rti-capture/rtiduino-pcb/gerbers/README.txt

rtiduino.GML	Mechanical (milling + outline)
rtiduino.GTL	TOP Copper
rtiduino.GTO	TOP silscreen
rtiduino.GTP	TOP paste
rtiduino.GTS	TOP solder mask
rtiduino.GBL	BOTTOM copper
rtiduino.GBO	BOTTOM silkscreen
rtiduino.GBP	BOTTOM paste
rtiduino.GBS	BOTTOM solder mask

rtiduino.TXT	EXCELLON drill file
	
rtiduino.dri	Drill information file
rtiduino.gpi	Photoplotter information file
