rti-capture/rtiduino-pcb/tester-1.0.xlsx

 | Number of Boards | 1
Qty | Value | Device | Package | Parts | Description | MPN | OC_FARNELL | Farnell £ | OC_Mouser | Mouser £ | Total QTY | Tot | Minimum | Multiple | Current Stock | Order Qty | Part, QTY | Item Cost | Total Cost | Order Farnel
1 |  | PINHD-1X2 | 1X02 | JP4 | PIN SOCKET | 2212S-02SG-85 | 1593458 | £0.0619 |  |  | 1 | 2 | 50 | 50 |  | 50 | 2212S-02SG-85 |50 | £0.0619 | £3.09 | 1593458,50
1 | ICSP | PINHD-2X3 | 2X03 | ICSP | PIN SOCKET | 2214S-06SG-85 | 1593488 | £0.1870 |  |  | 1 | 2 | 5 | 5 |  | 5 | 2214S-06SG-85 |5 | £0.1870 | £0.94 | 1593488,5
3 |  | PINHD-2X5 | 2X05 | JP7, JP8, JP9 | PIN SOCKET | 2214S-10SG-85 | 1593490 | £0.2620 |  |  | 3 | 4 | 5 | 5 |  | 5 | 2214S-10SG-85 |5 | £0.2620 | £1.31 | 1593490,5
1 |  | PINHD-2X8 | 2X08 | JP3 | PIN SOCKET | 2214S-16SG-85 | 1593492 | £0.3280 |  |  | 1 | 2 | 5 | 5 |  | 5 | 2214S-16SG-85|5 | £0.3280 | £1.64 | 1593492,5
1 | ICSP | PINHD-2X3 | 2X03 | ICSP1 | PIN HEADER | 826925-3 | 1248132 | £0.4810 |  |  | 1 | 2 | 10 | 10 | 13 | 0 | 826925-3 |0 | £0.4810 | £0.00
16 | 187 | R-EU_R0805 | R0805 | R35, R36, R37, R38, R39, R40, R41, R42, R43, R44, R45, R46, R47, R48, R49, R50 | RESISTOR, European symbol | MCWR08X1870FTL | 2695006 | £0.0048 |  |  | 16 | 18 | 10 | 10 |  | 20 | MCWR08X1870FTL |20 | £0.0048 | £0.10 | 2695006,20
26 | 200 | R-EU_R0805 | R0805 | R1, R2, R3, R4, R5, R6, R7, R8, R9, R10, R11, R12, R13, R14, R15, R16, R17, R18, R19, R20, R21, R22, R23, R24, R25, R26 | RESISTOR, European symbol | MCWR08X2000FTL | 2447602 | £0.0066 |  |  | 26 | 29 | 10 | 10 |  | 30 | MCWR08X2000FTL |30 | £0.0066 | £0.20 | 2447602,30
8 | 768 | R-EU_R0805 | R0805 | R27, R28, R29, R30, R31, R32, R33, R34 | RESISTOR, European symbol | ERJ6ENF7680V | 2303538 | £0.0386 |  |  | 8 | 9 | 10 | 10 |  | 10 | ERJ6ENF7680V |10 | £0.0386 | £0.39 | 2303538,10
6 | DOWN | 10-XX | B3F-10XX | GO, STOP, UP, DOWN, FOCUSON, RESET | OMRON SWITCH | SKHHAKA010 | 1656423 | £0.1540 |  |  | 6 | 7 | 10 | 10 | 10 | 0 | SKHHAKA010|0 | £0.1540 | £0.00
76 | Green | LEDCHIP-LED0805 | CHIP-LED0805 | QA0, QA1, QA2, QA3, QA4, QA5, QA6, QA7, QA8, QA9, QA10, QA11, QA12, QA13, QA14, QA15, QA16, QA17, QA18, QB0, QB1, QB2, QB3, QB4, QB5, QB6, QB7, QB8, QB9, QB10, QB11, QB12, QB13, QB14, QB15, QB16, QB17, QB18, QC0, QC1, QC2, QC3, QC4, QC5, QC6, QC7, QC8, QC9, QC10, QC11, QC12, QC13, QC14, QC15, QC16, QC17, QC18, QD0, QD1, QD2, QD3, QD4, QD5, QD6, QD7, QD8, QD9, QD10, QD11, QD12, QD13, QD14, QD15, QD16, QD17, QD18 | LED | KP-2012SGC | 1318243 | £0.0811 |  |  | 76 | 84 | 50 | 5 |  | 85 | KP-2012SGC|85 | £0.0811 | £6.89 | 1318243,85
8 | Orange | LEDCHIP-LED0805 | CHIP-LED0805 | B0, B1, B2, B3, B4, B5, B6, B7 | LED | KP-2012EC | 8529922 | £0.1030 |  |  | 8 | 9 | 5 | 5 |  | 10 | KP-2012EC|10 | £0.1030 | £1.03 | 8529922,10
18 | Red | LEDCHIP-LED0805 | CHIP-LED0805 | A0, A1, A2, A3, A4, A5, A6, A7, C0, C1, C2, C3, C4, C5, C6, C7, FOCUS, SHUTTER | LED | KP-2012SEC | 8529949 | £0.1500 |  |  | 18 | 20 | 5 | 5 |  | 20 | KP-2012SEC|20 | £0.1500 | £3.00 | 8529949,20
52 | Yellow | LEDCHIP-LED0805 | CHIP-LED0805 | QA19, QA20, QA21, QA22, QA23, QA24, QA25, QA26, QA27, QA28, QA29, QA30, QA31, QB19, QB20, QB21, QB22, QB23, QB24, QB25, QB26, QB27, QB28, QB29, QB30, QB31, QC19, QC20, QC21, QC22, QC23, QC24, QC25, QC26, QC27, QC28, QC29, QC30, QC31, QD19, QD20, QD21, QD22, QD23, QD24, QD25, QD26, QD27, QD28, QD29, QD30, QD31 | LED | KP-2012YC | 1318247 | £0.0804 |  |  | 52 | 58 | 50 | 5 |  | 60 | KP-2012YC|60 | £0.0804 | £4.82 | 1318247,60
1 | LCD-09395 | LCD-09395 | LCD-09395 | LCD1 | Screen |  | MK00650 | £18.9900 |  |  | 1 | 2 | 1 | 1 |  | 0 | |0 | £18.9900 | £0.00
8 | VO1400AEFTR | VO1400AEFTR | SOP4 | U1, U2, U3, U4, U5, U6, U7, U8 | MOSFET Relay | VO1400AEFTR | 2396109 | £0.7060 |  |  | 8 | 9 | 1 | 1 |  | 9 | VO1400AEFTR|9 | £0.7060 | £6.35 | 2396109,9
4 |  | Standoff | 8mm |  | 8mm Standoff for Screen | 970080151 | 2884509 | £0.3150 |  |  | 4 | 5 | 1 | 1 |  | 5 | 970080151|5 | £0.3150 | £1.57 | 2884509,5
8 |  | Screws | M2.5 x 5mm | Machine Screw | M2.5, 5 mm, Stainless Steel, Pan Head Torx | 01.64.212 | 2494522 | £0.0368 |  |  | 8 | 9 | 10 | 10 |  | 10 | 01.64.212|10 | £0.0368 | £0.37 | 2494522,10
8 |  | Washer | 2.65mm x 5.6mm |  | ylon, Flat, 2.65mm x 5.6mm Pack of 50 | 110764 | 7047472 | £1.3500 |  |  | 8 | 9 | 1 | 1 |  | 1 | 110764|1 | £1.3500 | £1.35 | 7047472,1 |  | 50-pack
 |  |  |  |  |  |  |  |  |  |  |  |  |  |  |  |  |  |  | £33.05 | £33.05
 |  |  |  |  |  |  |  |  |  |  |  |  |  |  |  |  |  |  |  |  | £0.00
 |  |  |  |  |  |  |  |  |  |  |  |  |  |  |  |  |  |  |  | £39.67 | £39.67
