rti-capture/rtiduino-pcb/rtiduino-1.3.xlsx

 | Number of Boards | 2
Qty | Value | Device | Package | Parts | Description | MPN | OC_FARNELL | Farnell £ | OC_Mouser | Mouser £ | Total QTY | Tot | Minimum | Multiple | Current Stock | Order Qty | Part, QTY | Item Cost | Total Cost | Order Farnel | Order Mouser
1 |  | 10-XX | B3F-10XX | S1 | OMRON SWITCH | SKHHAKA010 | 1656423 | £0.1540 | 688-SKHHAK | 0.2380 | 2 | 3 | 10 | 10 |  | 10 | SKHHAKA010|10 | £0.1540 | £1.54 | 1656423,10 |  |  | 1656423,10
1 |  | PINHD-1X6 | 1X06 | JP2 | PIN HEADER | 826629-6 | 3418327 | £0.5090 | 571-826629-6 | 0.4800 | 2 | 3 | 10 | 10 |  | 10 | 826629-6|10 | £0.5090 | £5.09 | 3418327,10
3 |  | PINHD-2X5 | 2X05 | JP7, JP8, JP9 | PIN HEADER | 826942-5 | 1248161 | £0.4900 |  |  | 6 | 7 | 10 | 10 | 12 | 0 | 826942-5|0 | £0.4900 | £0.00
1 |  | PINHD-2X8 | 2X08 | JP3 | PIN HEADER | 825440-8 | 3417803 | £1.8800 |  |  | 2 | 3 | 1 | 1 | 10 | 0 | 825440-8|0 | £1.8800 | £0.00
1 |  | PINHD-1x2 | 1X02 | JP4 | PIN HEADER | 826629-2 | 3418285 | £0.2780 |  |  | 2 | 3 | 10 | 10 | 20 | 0 | 826629-2|0 | £0.2780 | £0.00
1 |  | PN61729 | PN61729 | X4 | BERG USB connector | USBR-B-S-S-O-TH | 1753809 | £1.2400 |  |  | 2 | 1 | 1 | 1 |  | 2 | USBR-B-S-S-O-TH|2 | £1.2400 | £2.48 | 1753809,2
21 | 100nF | C-EUC0805K | C0805K | C1, C4, C9, C10, C13, C14, C15, C16, C18, C24, C25, C26, C27, C28, C30, C31, C42, C43, C44, C45, C46 | CAPACITOR, European symbol | 08051C104KAT2A | 1740681 | £0.1390 |  |  | 42 | 47 | 10 | 10 |  | 50 | 08051C104KAT2A|50 | £0.1390 | £6.95 | 1740681,50
1 | 100uF | CPOL-EUE5-13 | E5-13 | C7 | POLARIZED CAPACITOR, European symbol | UPM1J101MPD | 8812667 | £0.7960 |  |  | 2 | 3 | 1 | 1 |  | 3 | UPM1J101MPD|3 | £0.7960 | £2.39 | 8812667,3
8 | 10K | R-EU_R0805 | R0805 | R5, R10, R36, R42, R43, R44, R45, R46 | RESISTOR, European symbol | ASC0805-10KFT5 | 2078962 | £0.0213 |  |  | 16 | 18 | 10 | 10 | 50 | 0 | ASC0805-10KFT5|0 | £0.0213 | £0.00
1 | 10uF | EEE-FK1J100P-CASE-D | CAPAE660X610N | C12 | Aluminum Electrolytic Capacitors,Surface Mount Type | EEE-FK1J100P | 9696008 | £0.3090 |  |  | 2 | 3 | 1 | 1 | 1 | 2 | EEE-FK1J100P|2 | £0.3090 | £0.62 | 9696008,2
1 | 120uF | CPOL-EUE5-13 | E5-13 | C6 | POLARIZED CAPACITOR, European symbol | UPM1J121MPD | 8812675 | £0.1490 |  |  | 2 | 3 | 1 | 1 |  | 3 | UPM1J121MPD|3 | £0.1490 | £0.45 | 8812675,3
1 | 16MHz | CRYTALHC49S | HC49/S | Q2 | CRYSTAL | X16M000000L259 | 9509925 | £1.7800 |  |  | 2 | 3 | 1 | 1 | 1 | 2 | X16M000000L259|2 | £1.7800 | £3.56 | 9509925,2 |  |  | SC08178 | £0.7100
9 | 1K | R-EU_R0805 | R0805 | R1, R11, R12, R40, R41, R3, R6, R7, R9 | RESISTOR, European symbol | CRCW08051K00FKEA | 1469847 | £0.0655 | 71-CRCW0805-1.0K-E3 | 0.0650 | 18 | 20 | 10 | 10 | 24 | 0 | CRCW08051K00FKEA|0 | £0.0655 | £0.00
1 | 2.5MM-JACKPRO | 2.5MM-JACKPRO | 2.5-JACK-RA-PRO | J3 | 2.5mm Stereo Jack | MJ-2348BO | 1267387 | £4.4300 |  |  | 2 | 3 | 5 | 5 | 14 | 0 | MJ-2348BO|0 | £4.4300 | £0.00 |  | 5-pack
1 | 3.5MM-JACK | 3.5MM-JACK | 3.5-JACK-RA | J2 | 3.5mm Stereo Jack | KLBR 4 | 1217016 | £2.0100 |  |  | 2 | 3 | 1 | 1 |  | 3 | KLBR 4|3 | £2.0100 | £6.03 | 1217016,3
2 | 4.7uF | C-EUC0805K | C0805K | C29, C32 | CAPACITOR, European symbol | 0805YC475KAT2A | 1657937 | £0.3760 | 581-0805YC475KAT2A | 0.3880 | 4 | 5 | 1 | 1 |  | 5 | 0805YC475KAT2A|5 | £0.3760 | £1.88 | 1657937,5
1 | 4K7 | R-EU_R0805 | R0805 | R8 | RESISTOR, European symbol | MCWF08P4701FTL | 2694141 | £0.0144 |  |  | 2 | 3 | 10 | 10 |  | 10 | MCWF08P4701FTL|10 | £0.0144 | £0.14 | 2694141,10
2 | 500mA | L-EUL1812 | L1812 | F1, F2 | INDUCTOR, European symbol | 1206L025YR | 1596990 | £0.2740 | 576-1206L025YR | 0.2880 | 4 | 5 | 10 | 10 | 20 | 0 | 1206L025YR|0 | £0.2740 | £0.00
28 | 560 | R-EU_R0805 | R0805 | R2, R4, R13, R14, R15, R16, R17, R18, R19, R20, R21, R22, R23, R24, R25, R26, R27, R28, R29, R30, R31, R32, R33, R34, R35, R37, R38, R39 | RESISTOR, European symbol | MCHP05W4F5600T5E | 1576455 | £0.0421 |  |  | 56 | 62 | 10 | 10 |  | 70 | MCHP05W4F5600T5E|70 | £0.0421 | £2.95 | 1576455,70
1 | BAT54C | BAT54C | SOT23 | D4 | Schottky Diodes | BAT54C+ | 2675346 | £0.0823 |  |  | 2 | 3 | 5 | 5 | 8 | 0 | BAT54C+|0 | £0.0823 | £0.00
1 | DCJ0202 | JACK-PLUG0 | SPC4077 | J1 | DC POWER JACK | PPW01010 | 3498419 | £0.5400 |  |  | 2 | 3 | 1 | 1 | 2 | 1 | PPW01010|1 | £0.5400 | £0.54 | 3498419,1
1 | LED-DRIVER | LED-DRIVER | LDU08 | U6 | LED Driver | LDU0830S350 | 1738292 | £6.5700 |  |  | 1 | 2 | 1 | 1 |  | 2 | LDU0830S350|2 | £6.5700 | £13.14 | 1738292,2
1 | MBRS130 | DIODE-DO214AA | DO214AA | D5 | Schottky Rectifier | MBRS130 | 1467524 | £0.3450 | 512-MBRS130 | 0.3800 | 2 | 3 | 5 | 5 |  | 5 | MBRS130|5 | £0.3450 | £1.72 | 1467524,5
1 | SF37 | SF37 | DO-201AD | D2 | Ultrafast Diode | SF37 | 2677304 | £0.4740 |  |  | 2 | 3 | 5 | 5 |  | 5 | SF37|5 | £0.4740 | £2.37 | 2677304,5
1 | USB PROG | 47346-0001 | MOLEX_47346-0001 | J4 | CONN RCPT 5POS MICRO USB R/A SMD | 47346-0001 | 1568026 | £0.6250 | 538-47346-0001 | 0.7520 | 2 | 3 | 1 | 1 | 12 | 0 | 47346-0001|0 | £0.6250 | £0.00
4 |  | F15HPS | F15HP | X1, X5, X6, X7 | SUB-D | 3-106506-2 | 3417220 | £3.7600 |  |  | 8 | 9 | 1 | 1 | 3 | 6 | 3-106506-2|6 | £3.7600 | £22.56 | 3417220,6 |  |  | Male | F15HPS | 1-338169-2 | 2452348 | 454-3359
Misc Bits
1 | 1m | RibbonCable | 16-core |  | Ribbon Cable (screen/switches) | 3365-16 | 297318 | £2.3900 |  |  | 2 | 1 | 1 | 1 |  | 1 | 3365-16 |1 | £2.3900 | £2.39 | 297318,1
1 |  | IDC Connector | 2x08 |  | Ribbon Cable to Board | 90635-1161 | 3221956 | £0.7350 |  |  | 2 | 3 | 1 | 1 |  | 3 | 90635-1161|3 | £0.7350 | £2.21 | 3221956,3
1 | LCD-09395 | LCD-09395 | LCD-09395 | LCD1 | Screen | LCD-09395 | MK00650 | £18.9900 | 474-LCD-09395 | 22.1400 | 2 | 2 | 1 | 1 |  | 2 | LCD-09395|2 | £18.9900 | £37.98 | MK00650,2
5 |  | Switches | SPDT |  | Pushbutton Switch, Standard, 18000 Series, 6.5 mm, SPDT, On-(On), Plunger | 18535CD | 1082278 | £5.6800 |  |  | 5 | 5 | 1 | 1 |  | 5 | 18535CD|5 | £5.6800 | £28.40 | 1082278,5
1 |  | Green switch cap |  |  | Switch Cap, 18000 Series Snap Action Momentary Pushbutton Switches, Green | U483 | 1082523 | £0.5590 |  |  | 2 | 3 | 10 | 10 |  | 10 | U483|10 | £0.5590 | £5.59 | 1082523,10
1 |  | Red switch cap |  |  | Switch Cap, 13000 Series Snap Action Momentary Pushbutton Switches, Red | U486 | 1082524 | £0.5670 |  |  | 2 | 3 | 10 | 10 |  | 10 | U486|10 | £0.5670 | £5.67 | 1082524,10
3 |  | Black switch cap |  |  | Switch Cap, Snap Action Momentary Pushbutton Switches, Black | U482 | 1082522 | £0.3470 |  |  | 6 | 7 | 10 | 10 |  | 10 | U482|10 | £0.3470 | £3.47 | 1082522,10
4 |  | Female D-Sub |  |  |  | 5502-15SA-01-F1 | 1084693 | £0.4440 |  |  | 8 | 9 | 5 | 5 |  | 10 | 5502-15SA-01-F1 |10 | £0.4440 | £4.44 | 1084693,10
8 |  | Male D-Sub |  |  |  | 5502-15PA-01-F1 | CN11131 | £0.3300 |  |  | 8 | 8 | 1 | 1 |  | 8 | 5502-15PA-01-F1|8 | £0.3300 | £2.64 | CN11131,8 |  |  | 1084686
12 |  | D-Sub Shells |  |  |  | MHDM-15-K | 4303441 | £3.5900 |  |  | 12 | 12 | 1 | 1 | 3 | 9 | MHDM-15-K|9 | £3.5900 | £32.31 | 4303441,9
8 |  | D Sub Jack Screw |  |  |  | SPC15082. | CN21810 | £0.6400 |  |  | 16 | 16 | 1 | 1 |  | 16 | SPC15082.|16 | £0.6400 | £10.24 | CN21810,16 |  |  | 2293865
1 |  | Box |  |  | Plastic Enclosure, Desktop Case, Instrument, ABS, 70.75 mm, 140 mm, 190 mm, IP43 | MCRM2055L | 1635117 | £12.9300 |  |  | 2 | 3 | 1 | 1 |  | 2 | MCRM2055L|2 | £12.9300 | £25.86 | 1635117,2
 |  |  |  |  |  |  |  |  |  |  |  |  |  |  |  |  |  | £135.3350
1 | 330uH (DO3308P-334) | DO3316P | DO3316P | L3 | COILCRAFT | DO3308P-334MLB | 2457508 | £1.1100 | 994-DO3308P-334MLD | 1.6700 | 2 | 3 | 1 | 1 | 1 | 2 | DO3308P-334MLB|2 | £1.6700 | £3.34 |  | 994-DO3308P-334MLD |2
1 | DR73-680-R | DR73-680-R | INDM7676X355N | L2 | POWER INDUCTOR | DR73-680-R | 1653721 | £2.0800 | 704-DR73-680-R | 0.9200 | 2 | 3 | 1 | 1 | 1 | 2 | DR73-680-R|2 | £0.9150 | £1.83 |  | 704-DR73-680-R |2
1 | 3uH | WE-TPC-744053003_5818/5828 | WE-TPC_5818/5828 | L1 | Shielded Tiny Power Inductor WE-TPC | 744053003 | 2082565 | £1.5000 | 710-744053003 | 1.1600 | 2 | 3 | 1 | 1 | 1 | 2 | 744053003|2 | £1.1600 | £2.32 |  | 710-744053003|2
5 |  | LEDCHIP-LED0805 | CHIP-LED0805 | L, RX, RX1, TX, TX1 | LED | 150080RS75000 | 2322077 | £0.1770 | 150080RS75000 | 0.1370 | 10 | 11 | 5 | 5 | 20 | 0 | 150080RS75000|0 | £0.1370 | £0.00
3 | 22p | C-EUC0805K | C0805K | C2, C3, C11 | CAPACITOR, European symbol | 08051A220JAT2A | 317500 | £0.1210 | 581-08051A220J | 0.0920 | 6 | 7 | 10 | 10 |  | 10 | 08051A220JAT2A|10 | £0.0920 | £0.92 |  | 581-08051A220J|10
1 | 47UF | EEE-FK1J470P-CASE-F | CAPAE830X1050N | C8 | Aluminum Electrolytic Capacitors,Surface Mount Type | EEE-FK1J470P | 9696032 | £0.7610 | 667-EEE-FK1J470P | 0.5860 | 2 | 3 | 1 | 1 | 1 | 2 | EEE-FK1J470P|2 | £0.5860 | £1.17 |  | 667-EEE-FK1J470P|2
2 | FOD852 | FOD852 | DIP4-SMD | U5, U7 | Optocoupler | FOD8523S | 1495374 | £0.9070 | 512-FOD8523S | 0.7920 | 4 | 5 | 5 | 5 | 8 | 0 | FOD8523S|0 | £0.7920 | £0.00
24 | AQV252G | AQV252G | SOP6 | U10, U11, U12, U13, U14, U15, U16, U17, U20, U21, U22, U23, U24, U25, U26, U27, U30, U31, U32, U33, U34, U35, U36, U37 | MOSFET Relay | AQV252GA | 2396106 | £4.1800 | 769-AQV252GA | 3.7400 | 48 | 53 | 25 | 1 |  | 50 | AQV252GA|50 | £3.7400 | £187.00 |  | 769-AQV252GA|50
1 | ICSP | PINHD-2X3 | 2X03 | ICSP | PIN HEADER | 826925-3 | 1248132 | £0.4810 | 571-826925-3 | 0.4720 | 2 | 3 | 10 | 10 | 13 | 0 | 826925-3|0 | £0.4720 | £0.00
1 | LM2594HVM-5.0 | LM2594HVM-5.0 | SOIC127P620X175-8N | U3 | SIMPLE SWITCHER | LM2594HVM-5.0/NOPB | 3122872 | £5.3400 | 926-LM2594HVM5.0NOPB | 4.6600 | 2 | 3 | 1 | 1 | 3 | 0 | LM2594HVM-5.0/NOPB|0 | £4.6600 | £0.00
1 | 122-000-04-52 | 122-000-04-52 | 122-000-04-52 | U$28 | Circuit Board Indicator | 553-0112-200F | 1519390 | £2.0000 | 645-553-0112-200F | 1.5800 | 2 | 3 | 1 | 1 |  | 3 | 553-0112-200F|3 | £1.5800 | £4.74 |  | 645-553-0112-200F|3
1 | ATMEGA2560AU | ATMEGA2560AU | TQFP100 | U1 | MICROCONTROLLER | ATMEGA1280-16AU | 1455090 | £8.7600 | 556-ATMEGA1280-16AU | 8.4200 | 2 | 3 | 1 | 1 | 3 | 2 | ATMEGA1280-16AU|2 | £8.4200 | £16.84 |  | 556-ATMEGA1280-16AU|2
2 | FT232RL | FT232RL | SSOP28 | U2, U4 | USB UART | FT232RL | 1146032 |  | FT232RL-TUBE | 3.5600 | 4 | 5 | 1 | 1 | 1 | 4 | FT232RL|4 | £3.5600 | £14.24 |  | FT232RL-TUBE|4
1 | 68uF | CPOL-EUE5-13 | E5-13 | C5 | POLARIZED CAPACITOR, European symbol | UPW2A680MPD |  |  | 647-UPW2A680MPD | 0.4910 | 2 | 3 | 5 | 5 |  | 5 | UPW2A680MPD|5 | £0.4910 | £2.46 |  | 647-UPW2A680MPD|5
 |  |  |  |  |  |  |  |  |  |  |  |  |  |  |  |  |  |  | £470.46 | £209.74 | £234.8570
 |  |  |  |  |  |  |  |  |  |  |  |  |  |  |  |  |  |  | £564.55 | £209.74 | £234.86 | £444.60
 |  |  |  |  |  |  |  |  |  |  |  |  |  |  |  |  |  |  |  | £251.69 | £281.83 | £533.52
