rti-capture/rtiduino-pcb/rtiduino.xlsx

Qty | Value | Device | Package | Parts |  | onecall code | Avail? | minimum order | price | Quantity needed | Order Quantity | Line cost | Make | 2
10 | 100n | C-EU | C0805RND | C1, C4, C9, C10, C12, C13, C14, C15, C16, C17 | CAPACITOR, European symbol | 1740681 (http://onecall.farnell.com/avx/08051c104kat2a/cap-mlcc-0-1uf-100v-x7r-10-0805/dp/1740681) | Y | 10 | £0.20 | 20 | 20 | £4.00 | Total | £230.30
3 | 22p | C-EU | C0805RND | C2, C3, C11 | CAPACITOR, European symbol | 317500 (http://onecall.farnell.com/avx/08051a220jat2a/cap-mlcc-22pf-100v-c0g-np0-5-0805/dp/317500) | Y | 10 | £0.07 | 6 | 10 | £0.67
1 | 68uF | CPOL-EUE3.5-10 | E3,5-10 | C5 | POLARIZED CAPACITOR, European symbol | 9696210 (http://onecall.farnell.com/panasonic/eeued2c680/capacitor-68uf-160v/dp/9696210) | Y | 1 | £0.89 | 2 | 2 | £1.78
1 | 120uF | CPOL-EUR/2012-12R | R/2012-12R | C6 | POLARIZED CAPACITOR, European symbol | 1658060 | Y | 1 | £1.97 | 2 | 2 | £3.94
1 | 68uF | CPOL-EUR/2012-12R | R/2012-12R | C7 | POLARIZED CAPACITOR, European symbol | 1457489 | Y | 1 | £0.65 | 2 | 2 | £1.30
1 | 1N5817-B | 1N5817-B | DO41-7.6 | D1 | 1.0A SCHOTTKY BARRIER RECTIFIER | ALREADY BOUGHT |  |  |  | 2 | 2 | £0.00
1 | SF37 | SF37 | DO-201AD | D2 |  | 1625219 | Y | 1 | £0.11 | 2 | 2 | £0.23
1 | 500mA | L-EUL1812 | L1812 | F1 | INDUCTOR, European symbol | 1596990 (http://onecall.farnell.com/littelfuse/1206l025yr/fuse-resettable-1206-16v-250ma/dp/1596990) | Y | 10 | £0.36 | 2 | 10 | £3.60
1 | LM358D | LM358D | SO08 | IC7 | OP AMP also LM158; LM258; LM2904 | 1366578 (http://onecall.farnell.com/stmicroelectronics/lm358d/op-amp-dual-1-1mhz-0-6v-us-8soic/dp/1366578) | N | 1 | £0.45 | 2 | 2 | £0.90
1 | ICSP | PINHD-2X3 | 2X03 | ICSP | PIN HEADER | CN14399 (http://onecall.farnell.com/te-connectivity-amp/826925-3/header-straight-2x3way/dp/CN14399) | Y | 10 | £0.25 | 2 | 10 | £2.50
1 | DCJ0202 | JACK-PLUG0 | SPC4077 | J1 | DC POWER JACK unknown unknown | AV15150 | Y | 1 | £0.48 | 2 | 2 | £0.96
1 | 3.5MM-JACK | 3.5MM-JACK | 3.5-JACK-RA | J2 |  | 1217016 | Y | 1 | £1.25 | 2 | 2 | £2.50
1 | 2.5MM-JACK | 2.5MM-JACK | 2.5-JACK-RA | J3 |  | 1200127 | N | 1 | £0.91 | 2 | 2 | £1.82
3 |  | PINHD-2X5 | 2X05 | JP7, JP8, JP9 | PIN HEADER | 1248161 | Y | 10 | £0.60 | 6 | 10 | £6.00
3 |  | LED0805ROUND | 0805RND | L, RX, TX | LED | 2322077 (http://onecall.farnell.com/wurth-elektronik/150080rs75000/led-0805-red-150mcd-625nm/dp/2322077) | Y | 1 | £0.16 | 6 | 6 | £0.96
1 | 100uH | SBC10 | SBC10 | L1 | INDUCTOR | 2333635 | Y | 1 | £0.12 | 2 | 2 | £0.24
1 | 16MHz | CRYTALHC49S | HC49/S | Q2 | CRYSTAL | SC08178 (http://onecall.farnell.com/ael-crystals/x16m000000l259/crystal-16mhz/dp/SC08178) | Y (4) | 1 | £1.44 | 2 | 2 | £2.88
3 | 1K | R-EU_R0805 | R0805 | R1, R11, R12,R7, R9 | RESISTOR, European symbol | 1576459 (http://onecall.farnell.com/multicomp/mchp05w4f1001t5e/resistor-thick-film-1k-0-25w-1/dp/1576459) | Y | 50 | £0.06 | 6 | 50 | £3.00
24 | 560 | R-EU_R0805 | R0805 | R4, R13, R14, R15, R16, R17, R18, R19, R20, R21, R22, R23, R24, R25, R26, R27, R28, R29, R30, R31, R32, R33, R34, R35,R37, R38, R39 | RESISTOR, European symbol | 9334688 (http://onecall.farnell.com/multicomp/mc01w08055560r/resistor-0805-560r/dp/9334688) | Y | 50 | £0.03 | 48 | 50 | £1.50
2 | 10K | R-EU_R0805 | R0805 | R5, R36,R6, R10 | RESISTOR, European symbol | 2078962 | Y | 100 |  | 4 | 100 | £0.00
1 |  | SJ | SJ | RESET-EN | SMD solder JUMPER | - |  | - | - | 2 | -
1 |  | 10-XX | B3F-10XX | S1 | OMRON SWITCH | 1656423 | Y | 5 | £0.12 | 2 | 5 | £0.60
1 | NDT2955 | PMOSSOT223 | SOT223 | T1 | MOS FET | SC11042 (http://onecall.farnell.com/fairchild-semiconductor/ndt2955/mosfet-p-ch-60v-2-5a-sot-223/dp/SC11042) | Y (8) | 1 | £0.50 | 2 | 2 | £1.00
1 | FDN340P | PMOSSOT23 | SOT-23 | T2 | MOS FET | optional |  | - | - | 2 | -
1 | 122-000-04-52 | 122-000-04-52 | 122-000-04-52 | U$28 |  | 9737340 | Y | 1 | £2.59 | 2 | 2 | £5.18
1 | ATMEGA2560AU | ATMEGA2560AU | TQFP100 | U1 | MICROCONTROLLER | 1455090 | Y | 1 | £9.99 | 2 | 2 | £19.98
25 | AQV252G | AQV252G | SOP6 | U10, U11, U12, U13, U14, U15, U16, U17, U20, U21, U22, U23, U24, U25, U26, U27, U30, U31, U32, U33, U34, U35, U36, U37 |  | 2396106 | Y (130) | 1 | £3.86 | 25 | 25 | £96.50
1 | LDU240S500 | LDU240S500 | RELAY_LDU2430S700 | U2 |  | 1738293 |  | 1 | £8.92 | 2 | 2 | £17.84
1 | LM2594HVM-5.0 | LM2594HVM-5.0 | SOIC127P620X175-8N | U3 | SIMPLE SWITCHER LM2594HVM-33 1564635 41K3809 SOIC-8 National Semiconductor | 1469190 | Y | 1 | £3.53 | 2 | 2 | £7.06
1 | FT232RL | FT232RL | SSOP28 | U4 |  | 1146032 | Y | 1 | £3.92 | 2 | 2 | £7.84
1 | FOD852 | FOD852 | DIP4-SMD | U5 |  | 1495374 | Y | 5 | £0.70 | 2 | 5 | £3.50
4 |  | F15HPS | F15HP | X1, X5, X6, X7 | SUB-D | 2452348 | Y (211) | 1 | £3.68 | 8 | 8 | £29.44
1 |  | PN61729 | PN61729 | X4 | BERG USB connector | 1753809 | Y | 1 | £1.29 | 2 | 2 | £2.58
