rti-capture/rtiduino-pcb/tester.brd

## EAGLE design tester.brd (2020-08-04)

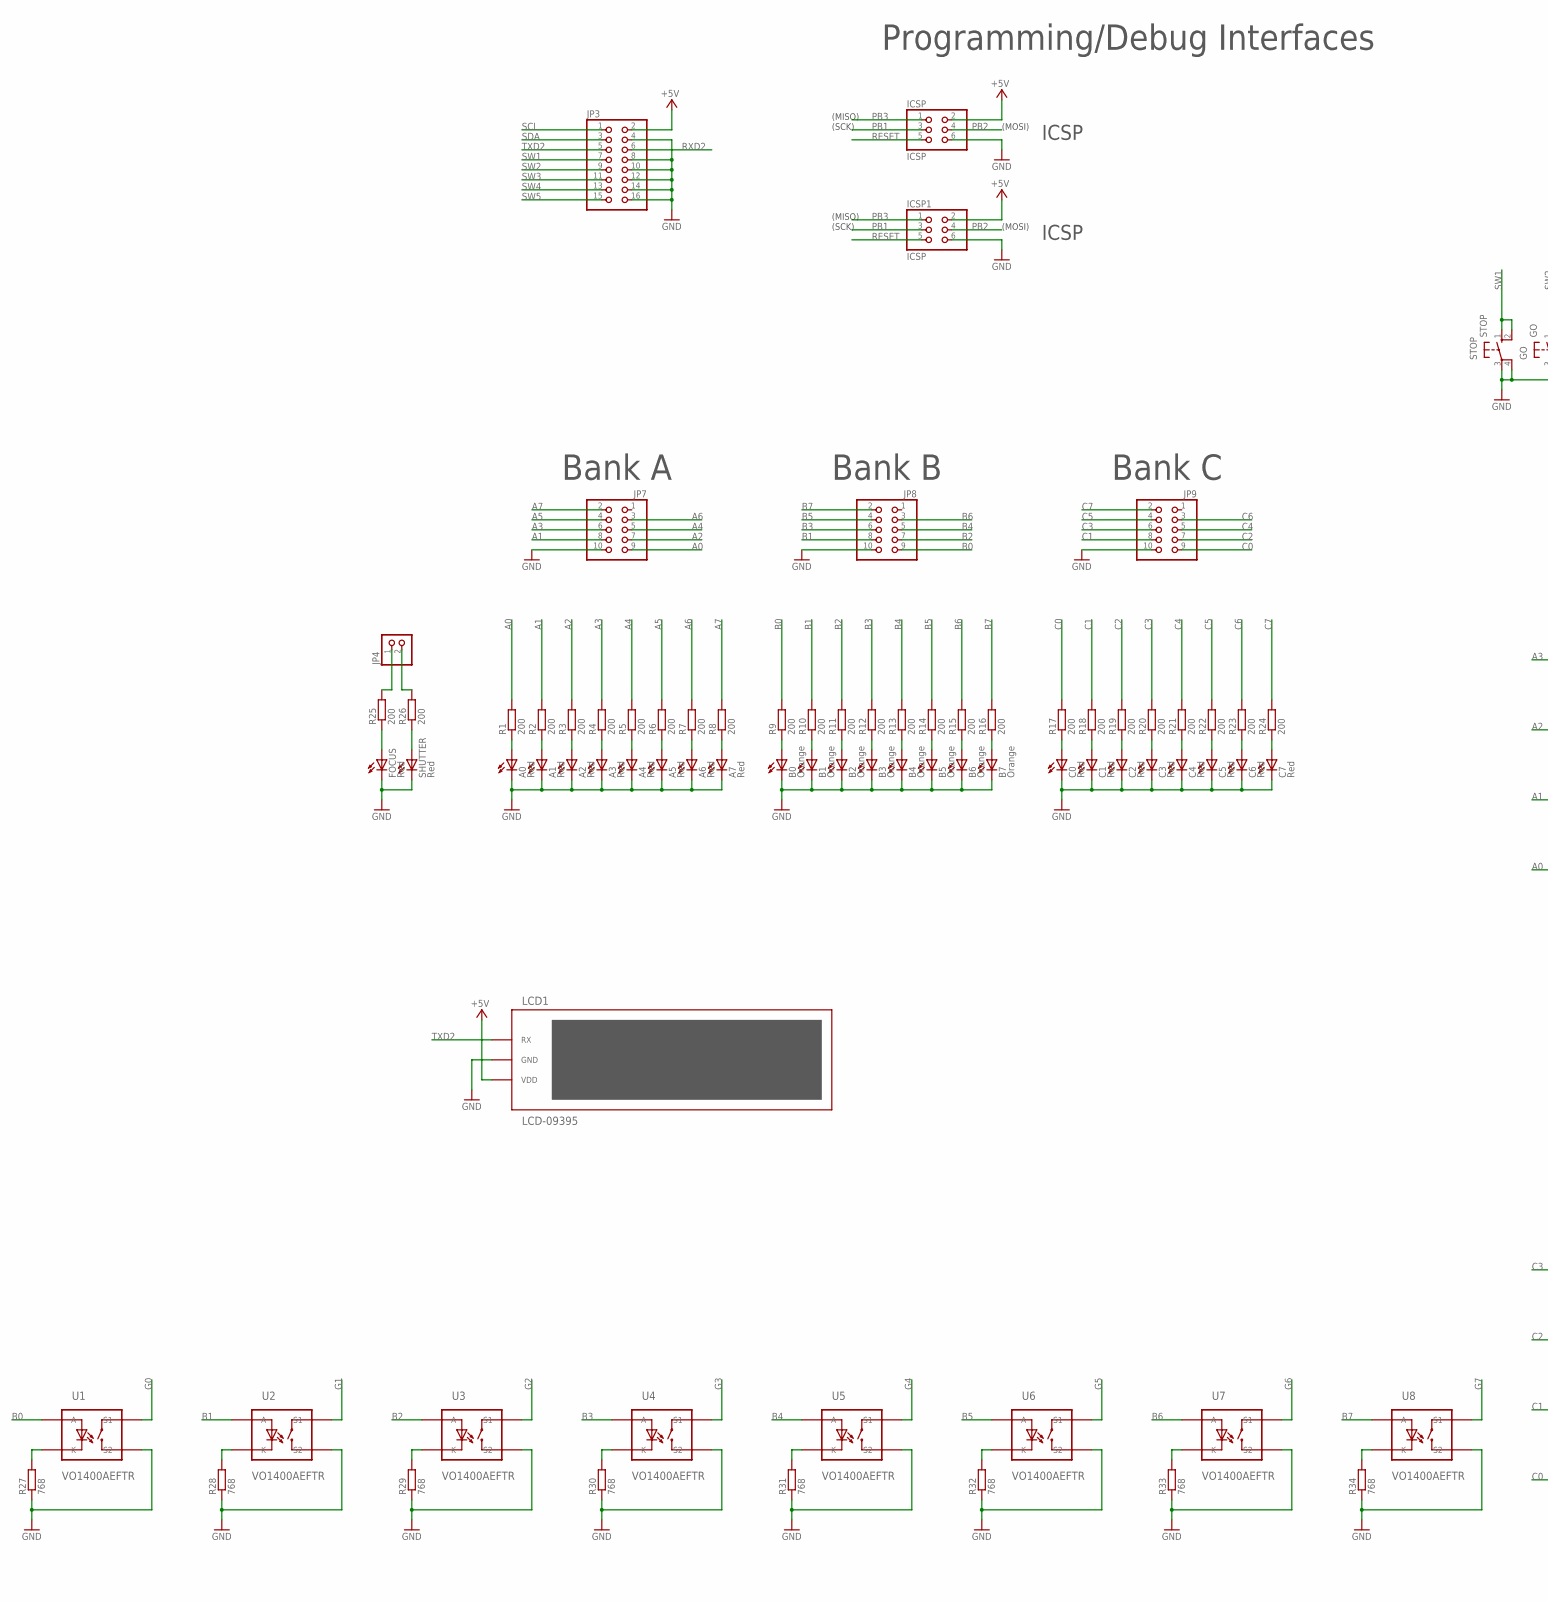
[picture p1: schematic tester.sch, part in row 1, column 1]

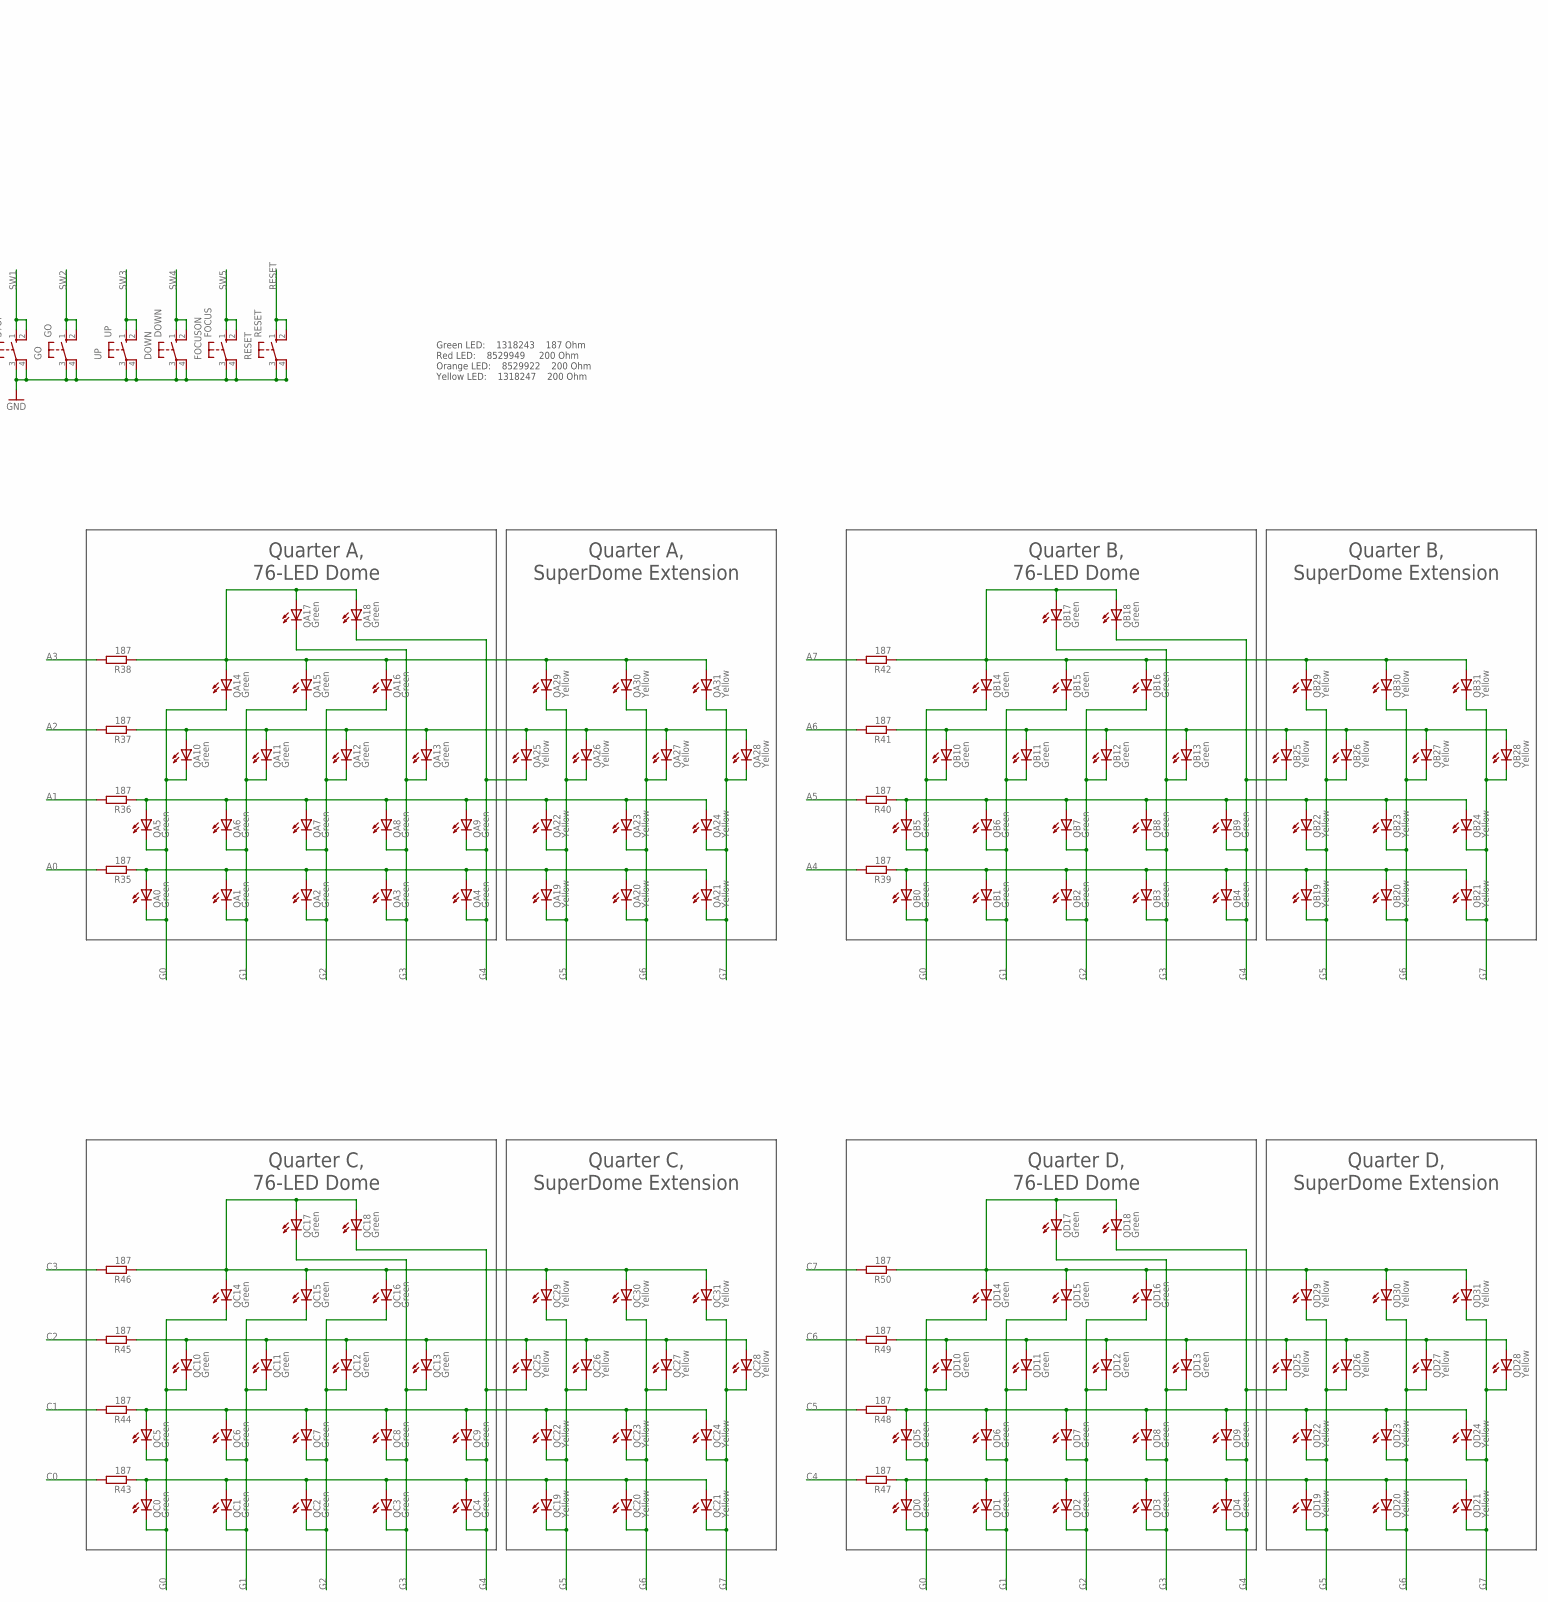
[picture p2: schematic tester.sch, part in row 1, column 2]

Parts:
A0, A1, A2, A3, A4, A5, A6, A7: Red; CHIP-LED0805
B0, B1, B2, B3, B4, B5, B6, B7: Orange; CHIP-LED0805
C0, C1, C2, C3, C4, C5, C6, C7: Red; CHIP-LED0805
DOWN: DOWN; B3F-10XX
FOCUS: Red; CHIP-LED0805
FOCUSON: FOCUS; B3F-10XX
GO: GO; B3F-10XX
ICSP, ICSP1: ICSP; 2X03
JP3: PINHD-2X8; 2X08
JP4: PINHD-1X2; 1X02
JP7, JP8, JP9: PINHD-2X5; 2X05
LCD1: LCD-09395
QA0, QA1, QA2, QA3, QA4, QA5, QA6, QA7, QA8, QA9, QA10, QA11, QA12, QA13, QA14, QA15, QA16, QA17, QA18: Green; CHIP-LED0805
QA19, QA20, QA21, QA22, QA23, QA24, QA25, QA26, QA27, QA28, QA29, QA30, QA31: Yellow; CHIP-LED0805
QB0, QB1, QB2, QB3, QB4, QB5, QB6, QB7, QB8, QB9, QB10, QB11, QB12, QB13, QB14, QB15, QB16, QB17, QB18: Green; CHIP-LED0805
QB19, QB20, QB21, QB22, QB23, QB24, QB25, QB26, QB27, QB28, QB29, QB30, QB31: Yellow; CHIP-LED0805
QC0, QC1, QC2, QC3, QC4, QC5, QC6, QC7, QC8, QC9, QC10, QC11, QC12, QC13, QC14, QC15, QC16, QC17, QC18: Green; CHIP-LED0805
QC19, QC20, QC21, QC22, QC23, QC24, QC25, QC26, QC27, QC28, QC29, QC30, QC31: Yellow; CHIP-LED0805
QD0, QD1, QD2, QD3, QD4, QD5, QD6, QD7, QD8, QD9, QD10, QD11, QD12, QD13, QD14, QD15, QD16, QD17, QD18: Green; CHIP-LED0805
QD19, QD20, QD21, QD22, QD23, QD24, QD25, QD26, QD27, QD28, QD29, QD30, QD31: Yellow; CHIP-LED0805
R1, R2, R3, R4, R5, R6, R7, R8, R9, R10, R11, R12, R13, R14, R15, R16, R17, R18, R19, R20, R21, R22, R23, R24, R25, R26: 200; R0805
R27, R28, R29, R30, R31, R32, R33, R34: 768; R0805
R35, R36, R37, R38, R39, R40, R41, R42, R43, R44, R45, R46, R47, R48, R49, R50: 187; R0805
RESET: RESET; B3F-10XX
SHUTTER: Red; CHIP-LED0805
STOP: STOP; B3F-10XX
U1, U2, U3, U4, U5, U6, U7, U8: VO1400AEFTR; SOP4
UP: UP; B3F-10XX

Connections:
+5V: ICSP.2, ICSP1.2, JP3.2, LCD1.P$3 (VDD)
A0: JP7.9, R1.2, R35.2
A1: JP7.8, R2.2, R36.2
A2: JP7.7, R3.2, R37.2
A3: JP7.6, R4.2, R38.2
A4: JP7.5, R5.2, R39.2
A5: JP7.4, R6.2, R40.2
A6: JP7.3, R7.2, R41.2
A7: JP7.2, R8.2, R42.2
B0: JP8.9, R9.2, U1.P$1 (A)
B1: JP8.8, R10.2, U2.P$1 (A)
B2: JP8.7, R11.2, U3.P$1 (A)
B3: JP8.6, R12.2, U4.P$1 (A)
B4: JP8.5, R13.2, U5.P$1 (A)
B5: JP8.4, R14.2, U6.P$1 (A)
B6: JP8.3, R15.2, U7.P$1 (A)
B7: JP8.2, R16.2, U8.P$1 (A)
C0: JP9.9, R17.2, R43.2
C1: JP9.8, R18.2, R44.2
C2: JP9.7, R19.2, R45.2
C3: JP9.6, R20.2, R46.2
C4: JP9.5, R21.2, R47.2
C5: JP9.4, R22.2, R48.2
C6: JP9.3, R23.2, R49.2
C7: JP9.2, R24.2, R50.2
FOCUS: JP4.1, R25.2
G0: QA0.C, QA5.C, QA10.C, QA14.C, QB0.C, QB5.C, QB10.C, QB14.C, QC0.C, QC5.C, QC10.C, QC14.C, QD0.C, QD5.C, QD10.C, QD14.C, U1.P$4 (S1)
G1: QA1.C, QA6.C, QA11.C, QA15.C, QB1.C, QB6.C, QB11.C, QB15.C, QC1.C, QC6.C, QC11.C, QC15.C, QD1.C, QD6.C, QD11.C, QD15.C, U2.P$4 (S1)
G2: QA2.C, QA7.C, QA12.C, QA16.C, QB2.C, QB7.C, QB12.C, QB16.C, QC2.C, QC7.C, QC12.C, QC16.C, QD2.C, QD7.C, QD12.C, QD16.C, U3.P$4 (S1)
G3: QA3.C, QA8.C, QA13.C, QA17.C, QB3.C, QB8.C, QB13.C, QB17.C, QC3.C, QC8.C, QC13.C, QC17.C, QD3.C, QD8.C, QD13.C, QD17.C, U4.P$4 (S1)
G4: QA4.C, QA9.C, QA18.C, QA25.C, QB4.C, QB9.C, QB18.C, QB25.C, QC4.C, QC9.C, QC18.C, QC25.C, QD4.C, QD9.C, QD18.C, QD25.C, U5.P$4 (S1)
G5: QA19.C, QA22.C, QA26.C, QA29.C, QB19.C, QB22.C, QB26.C, QB29.C, QC19.C, QC22.C, QC26.C, QC29.C, QD19.C, QD22.C, QD26.C, QD29.C, U6.P$4 (S1)
G6: QA20.C, QA23.C, QA27.C, QA30.C, QB20.C, QB23.C, QB27.C, QB30.C, QC20.C, QC23.C, QC27.C, QC30.C, QD20.C, QD23.C, QD27.C, QD30.C, U7.P$4 (S1)
G7: QA21.C, QA24.C, QA28.C, QA31.C, QB21.C, QB24.C, QB28.C, QB31.C, QC21.C, QC24.C, QC28.C, QC31.C, QD21.C, QD24.C, QD28.C, QD31.C, U8.P$4 (S1)
GND: A0.C, A1.C, A2.C, A3.C, A4.C, A5.C, A6.C, A7.C, B0.C, B1.C, B2.C, B3.C, B4.C, B5.C, B6.C, B7.C, C0.C, C1.C, C2.C, C3.C, C4.C, C5.C, C6.C, C7.C, DOWN.3, DOWN.4 (P1), FOCUS.C, FOCUSON.3, FOCUSON.4 (P1), GO.3, GO.4 (P1), ICSP.6, ICSP1.6, JP3.4, JP3.8, JP3.10, JP3.12, JP3.14, JP3.16, JP7.10, JP8.10, JP9.10, LCD1.P$2 (GND), R27.1, R28.1, R29.1, R30.1, R31.1, R32.1, R33.1, R34.1, RESET.3, RESET.4 (P1), SHUTTER.C, STOP.3, STOP.4 (P1), U1.P$3 (S2), U2.P$3 (S2), U3.P$3 (S2), U4.P$3 (S2), U5.P$3 (S2), U6.P$3 (S2), U7.P$3 (S2), U8.P$3 (S2), UP.3, UP.4 (P1)
unnamed: A0.A, R1.1
unnamed: A1.A, R2.1
unnamed: A2.A, R3.1
unnamed: A3.A, R4.1
unnamed: A4.A, R5.1
unnamed: A5.A, R6.1
unnamed: A6.A, R7.1
unnamed: A7.A, R8.1
unnamed: FOCUS.A, R25.1
unnamed: B0.A, R9.1
unnamed: B1.A, R10.1
unnamed: B2.A, R11.1
unnamed: B3.A, R12.1
unnamed: B4.A, R13.1
unnamed: B5.A, R14.1
unnamed: B6.A, R15.1
unnamed: B7.A, R16.1
unnamed: C0.A, R17.1
unnamed: C1.A, R18.1
unnamed: C2.A, R19.1
unnamed: C3.A, R20.1
unnamed: C4.A, R21.1
unnamed: C5.A, R22.1
unnamed: C6.A, R23.1
unnamed: C7.A, R24.1
unnamed: R26.1, SHUTTER.A
unnamed: R27.2, U1.P$2 (K)
unnamed: R28.2, U2.P$2 (K)
unnamed: QA0.A, QA1.A, QA2.A, QA3.A, QA4.A, QA19.A, QA20.A, QA21.A, R35.1
unnamed: QA5.A, QA6.A, QA7.A, QA8.A, QA9.A, QA22.A, QA23.A, QA24.A, R36.1
unnamed: QA10.A, QA11.A, QA12.A, QA13.A, QA25.A, QA26.A, QA27.A, QA28.A, R37.1
unnamed: QA14.A, QA15.A, QA16.A, QA17.A, QA18.A, QA29.A, QA30.A, QA31.A, R38.1
unnamed: R29.2, U3.P$2 (K)
unnamed: QB0.A, QB1.A, QB2.A, QB3.A, QB4.A, QB19.A, QB20.A, QB21.A, R39.1
unnamed: QB5.A, QB6.A, QB7.A, QB8.A, QB9.A, QB22.A, QB23.A, QB24.A, R40.1
unnamed: QB10.A, QB11.A, QB12.A, QB13.A, QB25.A, QB26.A, QB27.A, QB28.A, R41.1
unnamed: QB14.A, QB15.A, QB16.A, QB17.A, QB18.A, QB29.A, QB30.A, QB31.A, R42.1
unnamed: QC0.A, QC1.A, QC2.A, QC3.A, QC4.A, QC19.A, QC20.A, QC21.A, R43.1
unnamed: QC5.A, QC6.A, QC7.A, QC8.A, QC9.A, QC22.A, QC23.A, QC24.A, R44.1
unnamed: QC10.A, QC11.A, QC12.A, QC13.A, QC25.A, QC26.A, QC27.A, QC28.A, R45.1
unnamed: QC14.A, QC15.A, QC16.A, QC17.A, QC18.A, QC29.A, QC30.A, QC31.A, R46.1
unnamed: QD0.A, QD1.A, QD2.A, QD3.A, QD4.A, QD19.A, QD20.A, QD21.A, R47.1
unnamed: QD5.A, QD6.A, QD7.A, QD8.A, QD9.A, QD22.A, QD23.A, QD24.A, R48.1
unnamed: QD10.A, QD11.A, QD12.A, QD13.A, QD25.A, QD26.A, QD27.A, QD28.A, R49.1
unnamed: QD14.A, QD15.A, QD16.A, QD17.A, QD18.A, QD29.A, QD30.A, QD31.A, R50.1
unnamed: R30.2, U4.P$2 (K)
unnamed: R31.2, U5.P$2 (K)
unnamed: R32.2, U6.P$2 (K)
unnamed: R33.2, U7.P$2 (K)
unnamed: R34.2, U8.P$2 (K)
PB1: ICSP.3, ICSP1.3
PB2: ICSP.4, ICSP1.4
PB3: ICSP.1, ICSP1.1
RESET: ICSP.5, ICSP1.5, RESET.1 (S), RESET.2 (S1)
RXD2: JP3.6
SCL: JP3.1
SDA: JP3.3
SHUTTER: JP4.2, R26.2
SW1: JP3.7, STOP.1 (S), STOP.2 (S1)
SW2: GO.1 (S), GO.2 (S1), JP3.9
SW3: JP3.11, UP.1 (S), UP.2 (S1)
SW4: DOWN.1 (S), DOWN.2 (S1), JP3.13
SW5: FOCUSON.1 (S), FOCUSON.2 (S1), JP3.15
TXD2: JP3.5, LCD1.P$1 (RX)

Notes on the sheet:
(SCK)
(MISO)
(MOSI)
Programming/Debug Interfaces
ICSP
Bank A
Bank B
Bank C
Quarter A, 76-LED Dome
Quarter A, SuperDome Extension
Quarter B, 76-LED Dome
Quarter B, SuperDome Extension
Quarter C, 76-LED Dome
Quarter C, SuperDome Extension
Quarter D, 76-LED Dome
Quarter D, SuperDome Extension
Green LED: 1318243 187 Ohm Red LED: 8529949 200 Ohm Orange LED: 8529922 200 Ohm Yellow LED: 1318247 200 Ohm

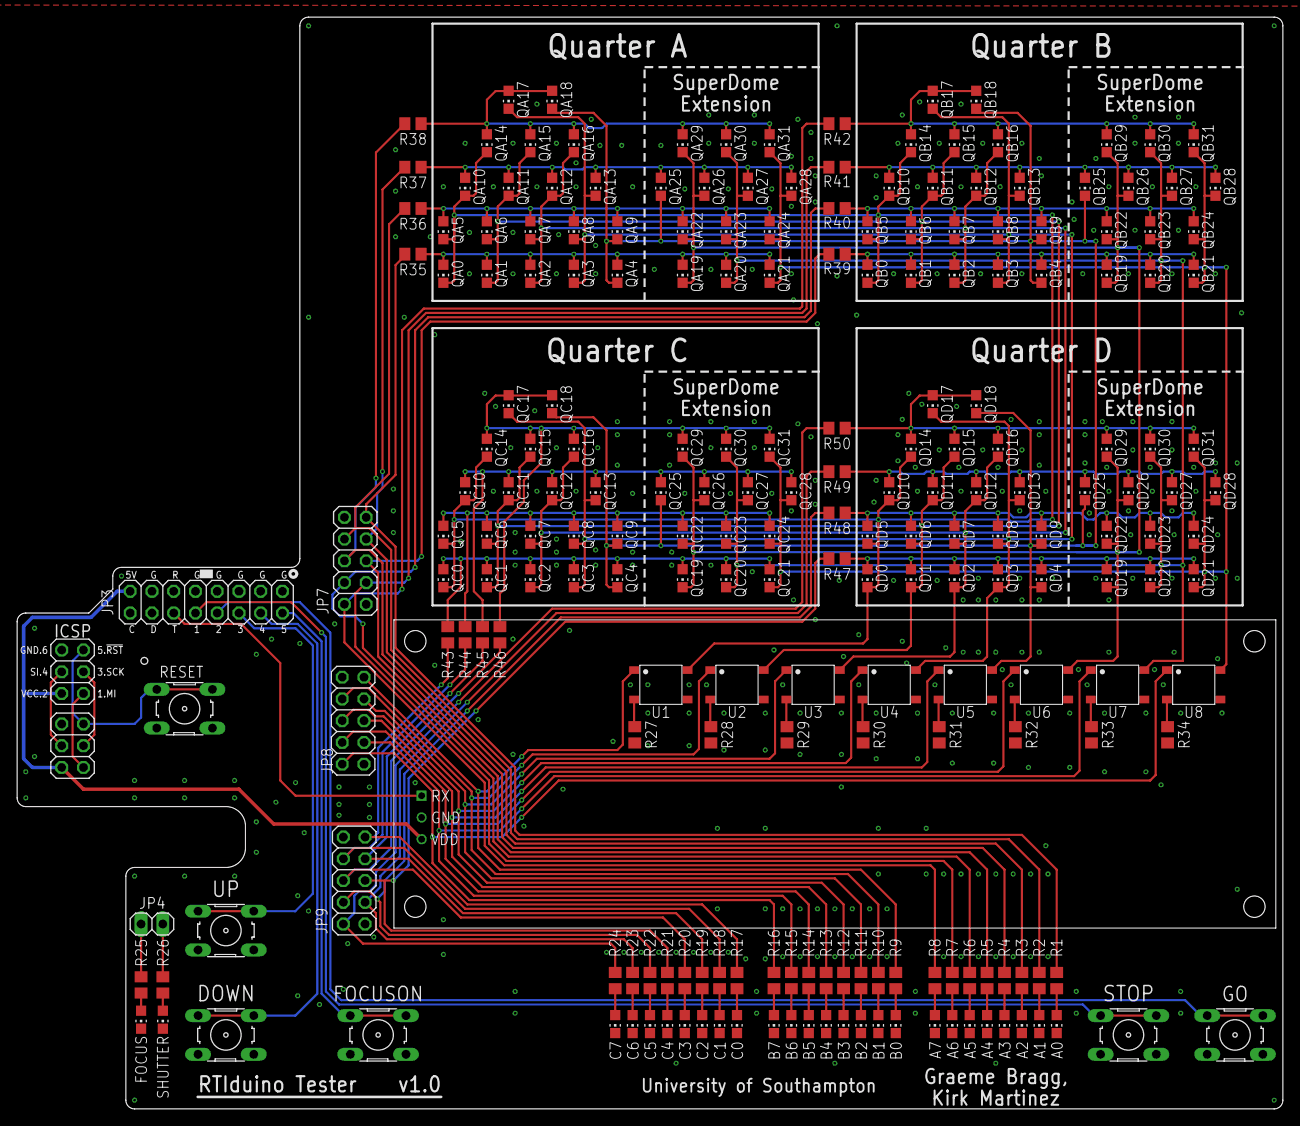
[picture p3: board tester.brd from above]

Board: 2 copper layers, 147.8 x 127.5 mm, 226 parts (0 on the bottom side), 96 nets.
