rti-capture/rtiduino-pcb/rtiduino.brd

## EAGLE design rtiduino.brd (2020-07-31)

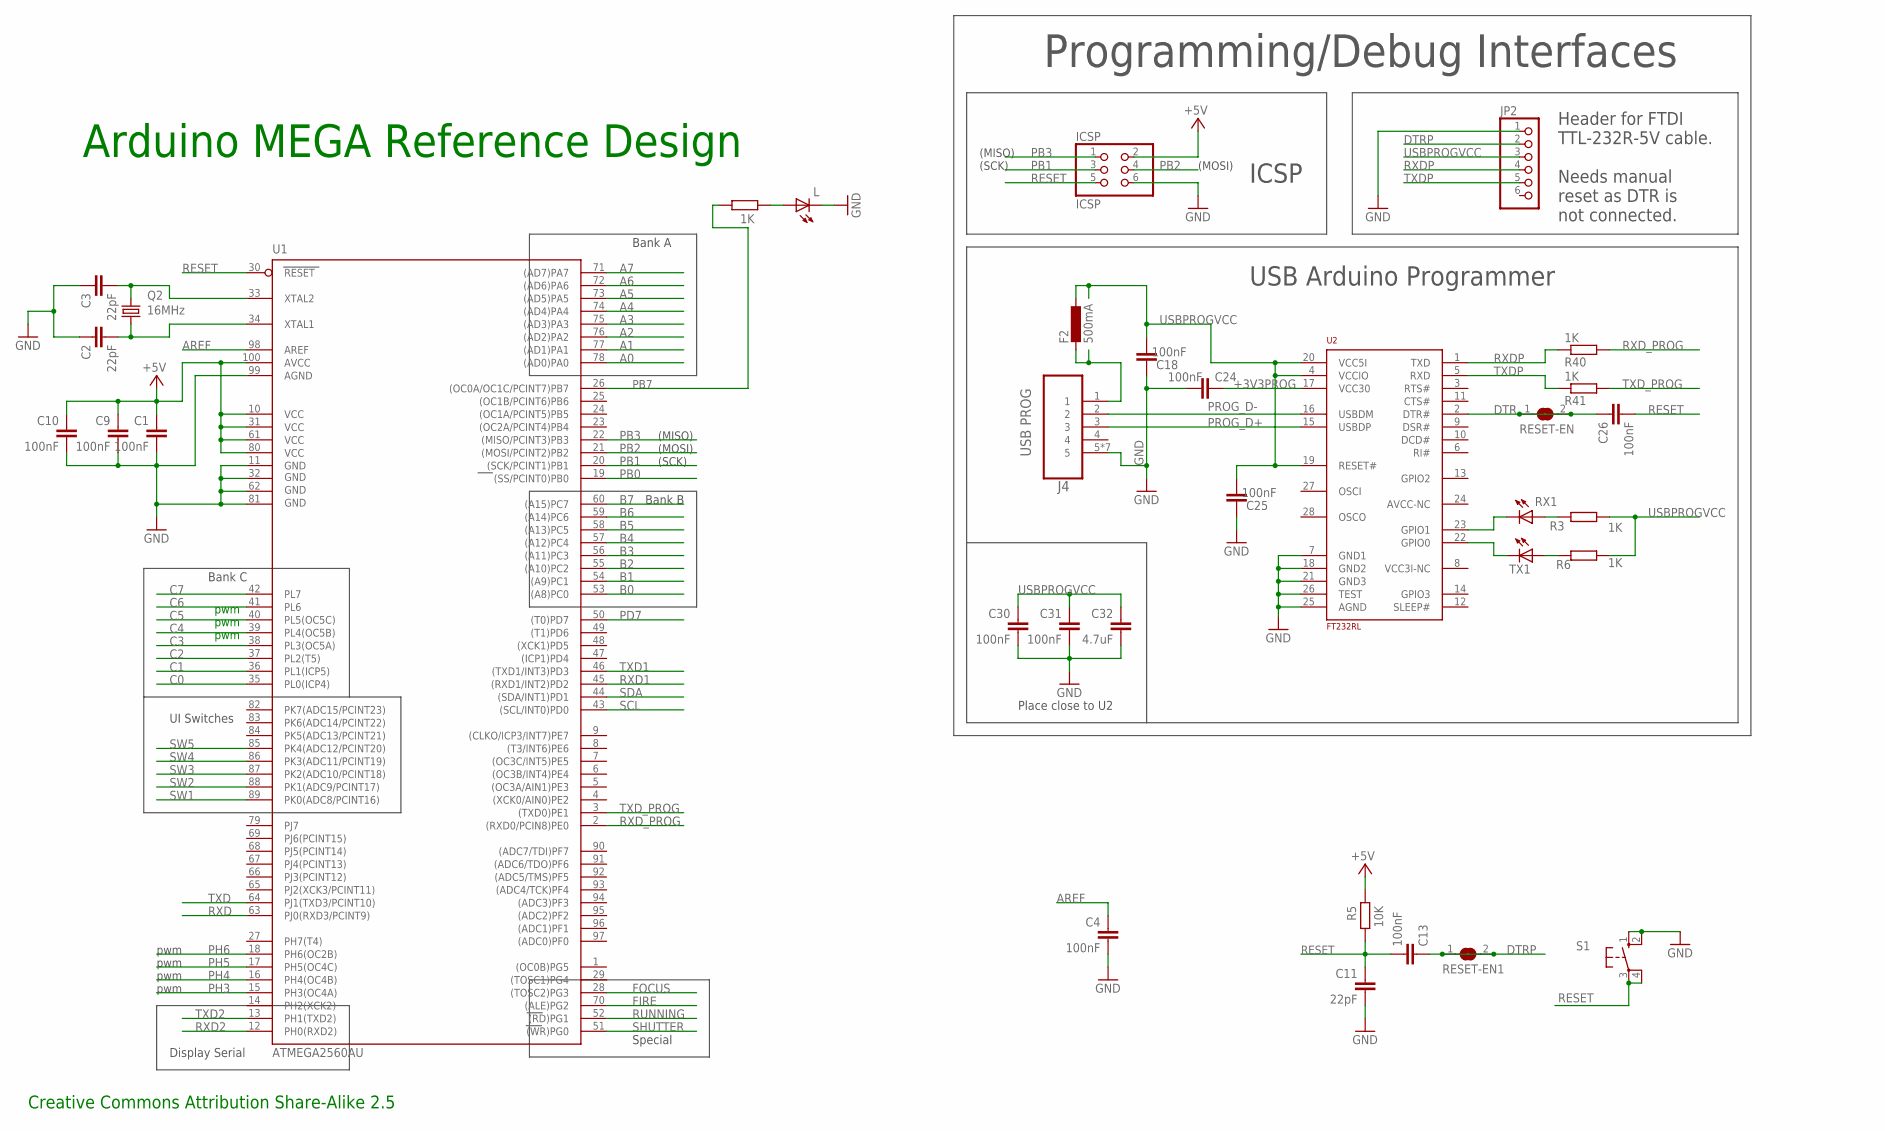
[picture p4: schematic rtiduino.sch, sheet 1]

Parts:
C1, C4, C9, C10, C13, C18, C24, C25, C26, C30, C31: 100nF; C0805K
C2, C3, C11: 22pF; C0805K
C32: 4.7uF; C0805K
F2: 500mA; L1812
ICSP: ICSP; 2X03
J4: USB PROG; MOLEX_47346-0001
JP2: PINHD-1X6; 1X06
L: LEDCHIP-LED0805; CHIP-LED0805
Q2: 16MHz; HC49/S
R1, R3, R6, R40, R41: 1K; R0805
R5: 10K; R0805
RESET-EN, RESET-EN1: SJ
RX1: LEDCHIP-LED0805; CHIP-LED0805
S1: 10-XX; B3F-10XX
TX1: LEDCHIP-LED0805; CHIP-LED0805
U1: ATMEGA2560AU; TQFP100
U2: FT232RL; SSOP28

Connections:
+3V3PROG: C24.2, U2.17 (VCC30)
+5V: C1.1, C9.1, C10.1, ICSP.2, R5.2, U1.10 (VCC), U1.31 (VCC1), U1.61 (VCC2), U1.80 (VCC3), U1.100 (AVCC); also elsewhere on the board
A0: U1.78 ((AD0)PA0); also elsewhere on the board
A1: U1.77 ((AD1)PA1); also elsewhere on the board
A2: U1.76 ((AD2)PA2); also elsewhere on the board
A3: U1.75 ((AD3)PA3); also elsewhere on the board
A4: U1.74 ((AD4)PA4); also elsewhere on the board
A5: U1.73 ((AD5)PA5); also elsewhere on the board
A6: U1.72 ((AD6)PA6); also elsewhere on the board
A7: U1.71 ((AD7)PA7); also elsewhere on the board
AREF: C4.1, U1.98 (AREF)
B0: U1.53 ((A8)PC0); also elsewhere on the board
B1: U1.54 ((A9)PC1); also elsewhere on the board
B2: U1.55 ((A10)PC2); also elsewhere on the board
B3: U1.56 ((A11)PC3); also elsewhere on the board
B4: U1.57 ((A12)PC4); also elsewhere on the board
B5: U1.58 ((A13)PC5); also elsewhere on the board
B6: U1.59 ((A14)PC6); also elsewhere on the board
B7: U1.60 ((A15)PC7); also elsewhere on the board
C0: U1.35 (PL0(ICP4)); also elsewhere on the board
C1: U1.36 (PL1(ICP5)); also elsewhere on the board
C2: U1.37 (PL2(T5)); also elsewhere on the board
C3: U1.38 (PL3(OC5A)); also elsewhere on the board
C4: U1.39 (PL4(OC5B)); also elsewhere on the board
C5: U1.40 (PL5(OC5C)); also elsewhere on the board
C6: U1.41 (PL6); also elsewhere on the board
C7: U1.42 (PL7); also elsewhere on the board
DTR: C26.1, RESET-EN.1, RESET-EN.2, U2.2 (DTR#)
DTRP: C13.1, JP2.2, RESET-EN1.1, RESET-EN1.2
FIRE: U1.70 ((ALE)PG2); also elsewhere on the board
FOCUS: U1.28 ((TOSC2)PG3); also elsewhere on the board
GND: C1.2, C2.1, C3.1, C4.2, C9.2, C10.2, C11.2, C18.2, C24.1, C25.2, C30.2, C31.2, C32.2, ICSP.6, J4.5, J4.M1 (5), J4.M2 (5), J4.M3 (5), J4.M4 (5), J4.M5 (5), J4.M6 (5), JP2.1, L.C, S1.1 (S), S1.2 (S1), U1.11 (GND), U1.32 (GND1), U1.62 (GND2), U1.81 (GND3), U1.99 (AGND), U2.7 (GND1), U2.18 (GND2), U2.21 (GND3), U2.25 (AGND), U2.26 (TEST); also elsewhere on the board
unnamed: L.A, R1.2
unnamed: C2.2, Q2.1, U1.34 (XTAL1)
unnamed: C3.2, Q2.2, U1.33 (XTAL2)
unnamed: RX1.C, U2.23 (GPIO1)
unnamed: TX1.C, U2.22 (GPIO0)
unnamed: R3.1, RX1.A
unnamed: R6.1, TX1.A
unnamed: F2.2, J4.1
PB0: U1.19 ((SS/PCINT0)PB0)
PB1: ICSP.3, U1.20 ((SCK/PCINT1)PB1)
PB2: ICSP.4, U1.21 ((MOSI/PCINT2)PB2)
PB3: ICSP.1, U1.22 ((MISO/PCINT3)PB3)
PB7: R1.1, U1.26 ((OC0A/OC1C/PCINT7)PB7)
PD7: U1.50 ((T0)PD7)
PH3: U1.15 (PH3(OC4A))
PH4: U1.16 (PH4(OC4B))
PH5: U1.17 (PH5(OC4C))
PH6: U1.18 (PH6(OC2B))
PROG_D+: J4.3, U2.15 (USBDP)
PROG_D-: J4.2, U2.16 (USBDM)
RESET: C11.1, C13.2, C26.2, ICSP.5, R5.1, S1.3, S1.4 (P1), U1.30 (RESET)
RUNNING: U1.52 ((RD)PG1); also elsewhere on the board
RXD: U1.63 (PJ0(RXD3/PCINT9)); also elsewhere on the board
RXD1: U1.45 ((RXD1/INT2)PD2)
RXD2: U1.12 (PH0(RXD2)); also elsewhere on the board
RXDP: JP2.4, R40.1, U2.1 (TXD)
RXD_PROG: R40.2, U1.2 ((RXD0/PCIN8)PE0)
SCL: U1.43 ((SCL/INT0)PD0); also elsewhere on the board
SDA: U1.44 ((SDA/INT1)PD1); also elsewhere on the board
SHUTTER: U1.51 ((WR)PG0); also elsewhere on the board
SW1: U1.89 (PK0(ADC8/PCINT16)); also elsewhere on the board
SW2: U1.88 (PK1(ADC9/PCINT17)); also elsewhere on the board
SW3: U1.87 (PK2(ADC10/PCINT18)); also elsewhere on the board
SW4: U1.86 (PK3(ADC11/PCINT19)); also elsewhere on the board
SW5: U1.85 (PK4(ADC12/PCINT20)); also elsewhere on the board
TXD: U1.64 (PJ1(TXD3/PCINT10)); also elsewhere on the board
TXD1: U1.46 ((TXD1/INT3)PD3)
TXD2: U1.13 (PH1(TXD2)); also elsewhere on the board
TXDP: JP2.5, R41.1, U2.5 (RXD)
TXD_PROG: R41.2, U1.3 ((TXD0)PE1)
USBPROGVCC: C18.1, C25.1, C30.1, C31.1, C32.1, F2.1, JP2.3, R3.2, R6.2, U2.4 (VCCIO), U2.19 (RESET#), U2.20 (VCC5I); also elsewhere on the board

Notes on the sheet:
Arduino MEGA Reference Design
(SCK)
(MISO)
(MOSI)
pwm
Creative Commons Attribution Share-Alike 2.5
Bank A
Bank B
Bank C
Special
Place close to U2
Programming/Debug Interfaces
ICSP
USB Arduino Programmer
Header for FTDI TTL-232R-5V cable. Needs manual reset as DTR is not connected.
UI Switches
Display Serial

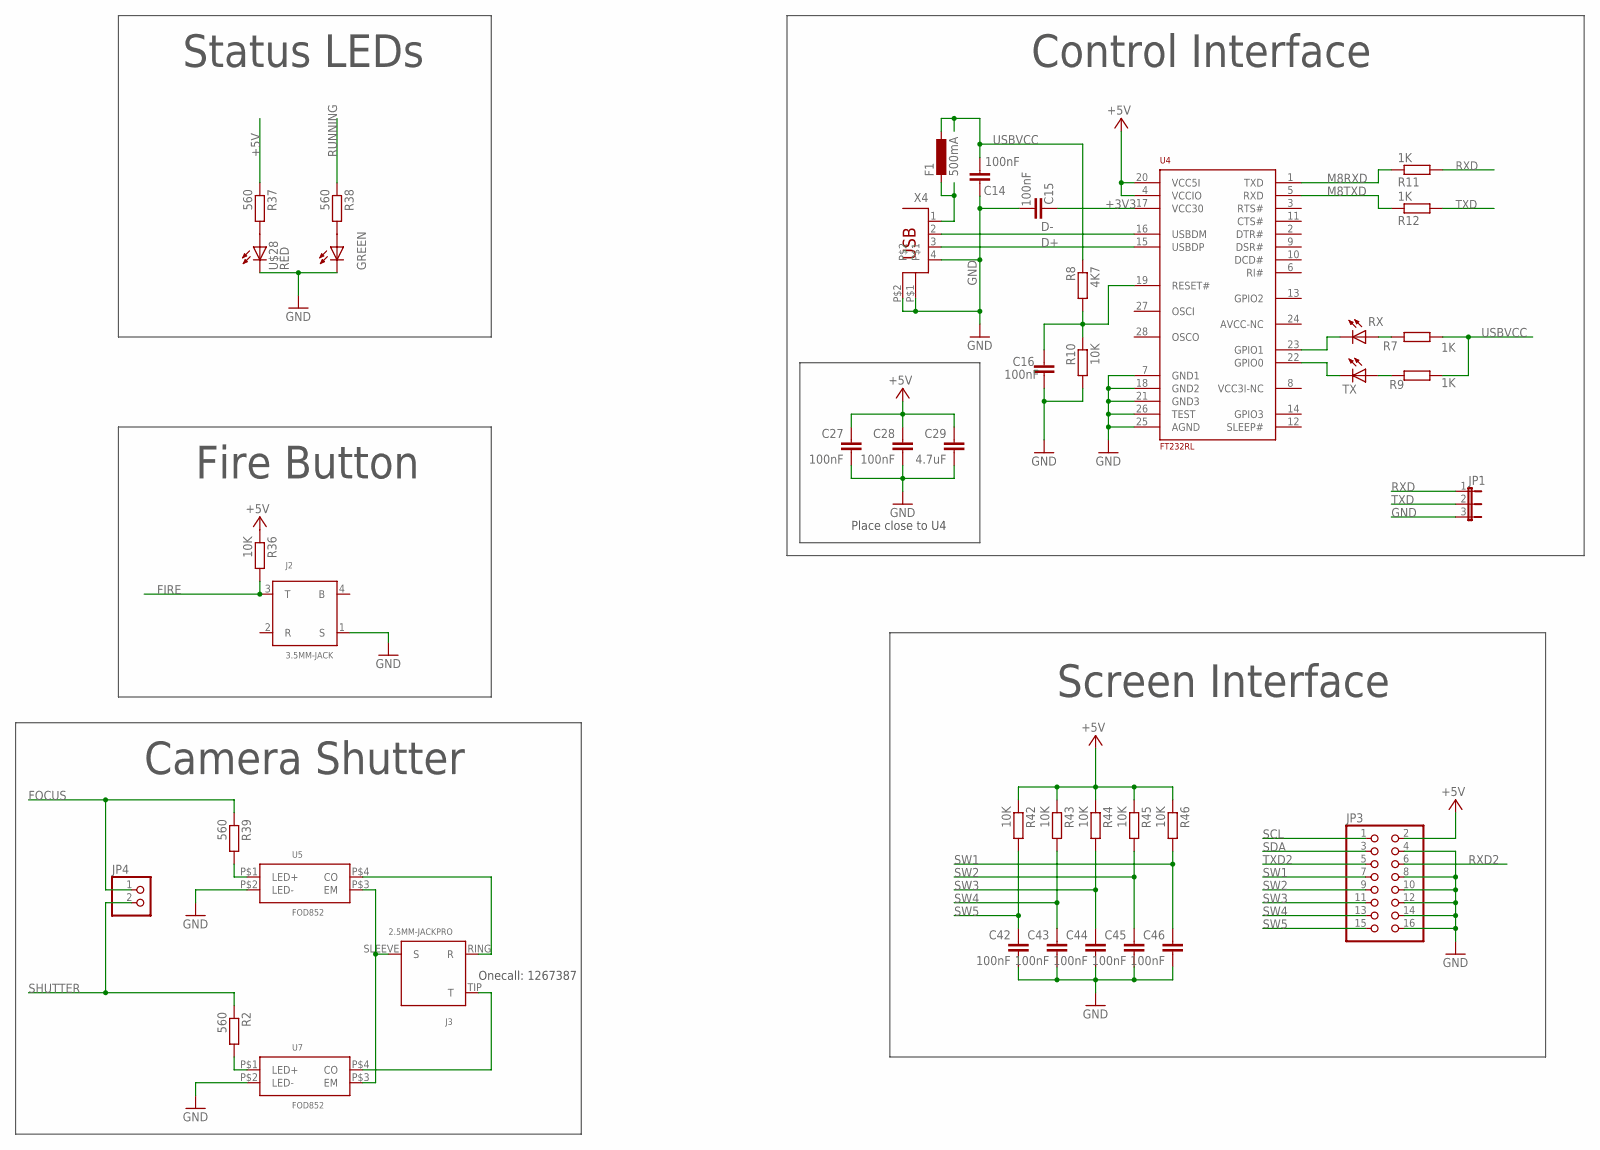
[picture p5: schematic rtiduino.sch, sheet 2, UI & Control]

Parts:
C14, C15, C16, C27, C28, C42, C43, C44, C45, C46: 100nF; C0805K
C29: 4.7uF; C0805K
F1: 500mA; L1812
J2: 3.5MM-JACK; 3.5-JACK-RA
J3: 2.5MM-JACKPRO; 2.5-JACK-RA-PRO
JP1: JP2E; JP2
JP3: PINHD-2X8; 2X08
JP4: PINHD-1X2; 1X02
R2, R37, R38, R39: 560; R0805
R7, R9, R11, R12: 1K; R0805
R8: 4K7; R0805
R10, R36, R42, R43, R44, R45, R46: 10K; R0805
RX: LEDCHIP-LED0805; CHIP-LED0805
TX: LEDCHIP-LED0805; CHIP-LED0805
U4: FT232RL; SSOP28
U5, U7: FOD852; DIP4-SMD
U$28: 122-000-04-52
X4: PN61729

Connections:
+3V3: C15.2, U4.17 (VCC30)
+5V: C27.1, C28.1, C29.1, JP3.2, R36.1, R37.1, R42.1, R43.1, R44.1, R45.1, R46.1, U4.4 (VCCIO), U4.20 (VCC5I); also elsewhere on the board
CAM_GND: J3.SLEEVE (S), U5.P$3 (EM), U7.P$3 (EM)
CAM_RING: J3.RING (R), U5.P$4 (CO)
CAM_SHUTTER: J3.TIP (T), U7.P$4 (CO)
D+: U4.15 (USBDP), X4.3
D-: U4.16 (USBDM), X4.2
FIRE: J2.3 (T), R36.2; also elsewhere on the board
FOCUS: JP4.1, R39.1; also elsewhere on the board
GND: C14.2, C15.1, C16.1, C27.2, C28.2, C29.2, C42.2, C43.2, C44.2, C45.2, C46.2, J2.1 (S), JP1.3, JP3.4, JP3.8, JP3.10, JP3.12, JP3.14, JP3.16, R10.2, U4.7 (GND1), U4.18 (GND2), U4.21 (GND3), U4.25 (AGND), U4.26 (TEST), U5.P$2 (LED-), U7.P$2 (LED-), U$28.P$1 (RC), U$28.P$3 (GC), X4.4, X4.P$1, X4.P$2; also elsewhere on the board
M8RXD: R11.1, U4.1 (TXD)
M8TXD: R12.1, U4.5 (RXD)
unnamed: RX.C, U4.23 (GPIO1)
unnamed: TX.C, U4.22 (GPIO0)
unnamed: R7.1, RX.A
unnamed: R9.1, TX.A
unnamed: R37.2, U$28.P$2 (RA)
unnamed: R38.2, U$28.P$4 (GA)
unnamed: R39.2, U5.P$1 (LED+)
unnamed: F1.2, X4.1
unnamed: R2.2, U7.P$1 (LED+)
unnamed: C16.2, R8.2, R10.1, U4.19 (RESET#)
RUNNING: R38.1; also elsewhere on the board
RXD: JP1.1, R11.2; also elsewhere on the board
RXD2: JP3.6; also elsewhere on the board
SCL: JP3.1; also elsewhere on the board
SDA: JP3.3; also elsewhere on the board
SHUTTER: JP4.2, R2.1; also elsewhere on the board
SW1: C46.1, JP3.7, R46.2; also elsewhere on the board
SW2: C45.1, JP3.9, R45.2; also elsewhere on the board
SW3: C44.1, JP3.11, R44.2; also elsewhere on the board
SW4: C43.1, JP3.13, R43.2; also elsewhere on the board
SW5: C42.1, JP3.15, R42.2; also elsewhere on the board
TXD: JP1.2, R12.2; also elsewhere on the board
TXD2: JP3.5; also elsewhere on the board
USBVCC: C14.1, F1.1, R7.2, R8.1, R9.2; also elsewhere on the board

Notes on the sheet:
Place close to U4
Control Interface
Status LEDs
Fire Button
Camera Shutter
Screen Interface
Onecall: 1267387
