rti-capture/rtiduino-pcb/rtiduino.brd

## EAGLE design rtiduino.brd (continued)

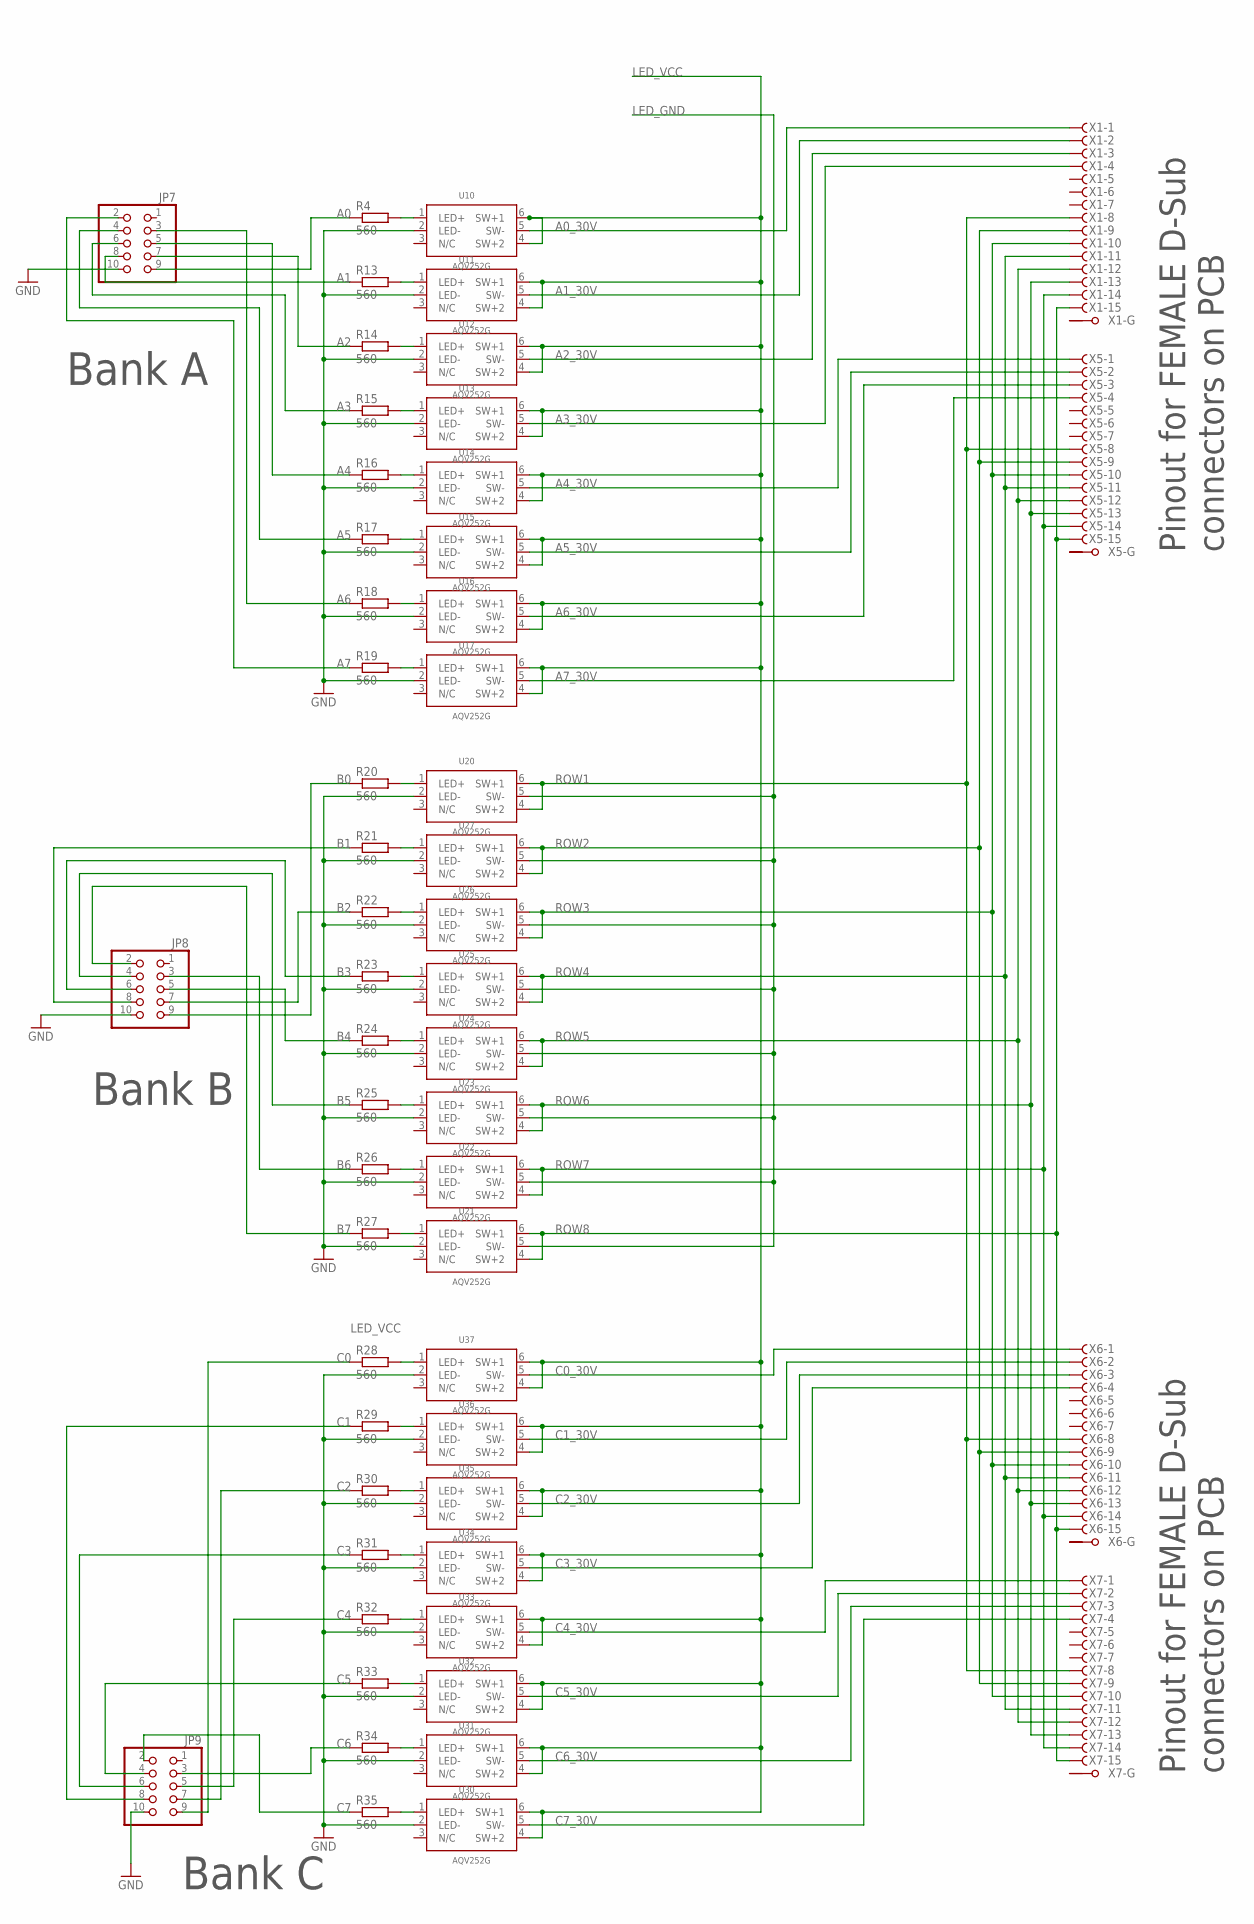
[picture p6: schematic rtiduino.sch, sheet 3, LED Control Matrix]

Parts:
JP7, JP8, JP9: PINHD-2X5; 2X05
R4, R13, R14, R15, R16, R17, R18, R19, R20, R21, R22, R23, R24, R25, R26, R27, R28, R29, R30, R31, R32, R33, R34, R35: 560; R0805
U10, U11, U12, U13, U14, U15, U16, U17, U20, U21, U22, U23, U24, U25, U26, U27, U30, U31, U32, U33, U34, U35, U36, U37: AQV252G; SOP6
X1, X5, X6, X7: F15HPS; F15HP

Connections:
A0: JP7.9, R4.1; also elsewhere on the board
A0_30V: U10.5 (SW-), X1.1 (F)
A1: JP7.8, R13.1; also elsewhere on the board
A1_30V: U11.5 (SW-), X1.2 (F)
A2: JP7.7, R14.1; also elsewhere on the board
A2_30V: U12.5 (SW-), X1.3 (F)
A3: JP7.6, R15.1; also elsewhere on the board
A3_30V: U13.5 (SW-), X1.4 (F)
A4: JP7.5, R16.1; also elsewhere on the board
A4_30V: U14.5 (SW-), X5.1 (F)
A5: JP7.4, R17.1; also elsewhere on the board
A5_30V: U15.5 (SW-), X5.2 (F)
A6: JP7.3, R18.1; also elsewhere on the board
A6_30V: U16.5 (SW-), X5.3 (F)
A7: JP7.2, R19.1; also elsewhere on the board
A7_30V: U17.5 (SW-), X5.4 (F)
B0: JP8.9, R20.1; also elsewhere on the board
B1: JP8.8, R21.1; also elsewhere on the board
B2: JP8.7, R22.1; also elsewhere on the board
B3: JP8.6, R23.1; also elsewhere on the board
B4: JP8.5, R24.1; also elsewhere on the board
B5: JP8.4, R25.1; also elsewhere on the board
B6: JP8.3, R26.1; also elsewhere on the board
B7: JP8.2, R27.1; also elsewhere on the board
C0: JP9.9, R28.1; also elsewhere on the board
C0_30V: U37.5 (SW-), X6.1 (F)
C1: JP9.8, R29.1; also elsewhere on the board
C1_30V: U36.5 (SW-), X6.2 (F)
C2: JP9.7, R30.1; also elsewhere on the board
C2_30V: U35.5 (SW-), X6.3 (F)
C3: JP9.6, R31.1; also elsewhere on the board
C3_30V: U34.5 (SW-), X6.4 (F)
C4: JP9.5, R32.1; also elsewhere on the board
C4_30V: U33.5 (SW-), X7.1 (F)
C5: JP9.4, R33.1; also elsewhere on the board
C5_30V: U32.5 (SW-), X7.2 (F)
C6: JP9.3, R34.1; also elsewhere on the board
C6_30V: U31.5 (SW-), X7.3 (F)
C7: JP9.2, R35.1; also elsewhere on the board
C7_30V: U30.5 (SW-), X7.4 (F)
GND: JP7.10, JP8.10, JP9.10, U10.2 (LED-), U11.2 (LED-), U12.2 (LED-), U13.2 (LED-), U14.2 (LED-), U15.2 (LED-), U16.2 (LED-), U17.2 (LED-), U20.2 (LED-), U21.2 (LED-), U22.2 (LED-), U23.2 (LED-), U24.2 (LED-), U25.2 (LED-), U26.2 (LED-), U27.2 (LED-), U30.2 (LED-), U31.2 (LED-), U32.2 (LED-), U33.2 (LED-), U34.2 (LED-), U35.2 (LED-), U36.2 (LED-), U37.2 (LED-); also elsewhere on the board
LED_GND: U20.5 (SW-), U21.5 (SW-), U22.5 (SW-), U23.5 (SW-), U24.5 (SW-), U25.5 (SW-), U26.5 (SW-), U27.5 (SW-); also elsewhere on the board
LED_VCC: U10.4 (SW+2), U10.6 (SW+1), U11.4 (SW+2), U11.6 (SW+1), U12.4 (SW+2), U12.6 (SW+1), U13.4 (SW+2), U13.6 (SW+1), U14.4 (SW+2), U14.6 (SW+1), U15.4 (SW+2), U15.6 (SW+1), U16.4 (SW+2), U16.6 (SW+1), U17.4 (SW+2), U17.6 (SW+1), U30.4 (SW+2), U30.6 (SW+1), U31.4 (SW+2), U31.6 (SW+1), U32.4 (SW+2), U32.6 (SW+1), U33.4 (SW+2), U33.6 (SW+1), U34.4 (SW+2), U34.6 (SW+1), U35.4 (SW+2), U35.6 (SW+1), U36.4 (SW+2), U36.6 (SW+1), U37.4 (SW+2), U37.6 (SW+1); also elsewhere on the board
unnamed: R4.2, U10.1 (LED+)
unnamed: R14.2, U12.1 (LED+)
unnamed: R15.2, U13.1 (LED+)
unnamed: R18.2, U16.1 (LED+)
unnamed: R16.2, U14.1 (LED+)
unnamed: R17.2, U15.1 (LED+)
unnamed: R13.2, U11.1 (LED+)
unnamed: R19.2, U17.1 (LED+)
unnamed: R28.2, U37.1 (LED+)
unnamed: R29.2, U36.1 (LED+)
unnamed: R30.2, U35.1 (LED+)
unnamed: R31.2, U34.1 (LED+)
unnamed: R32.2, U33.1 (LED+)
unnamed: R33.2, U32.1 (LED+)
unnamed: R34.2, U31.1 (LED+)
unnamed: R35.2, U30.1 (LED+)
unnamed: R20.2, U20.1 (LED+)
unnamed: R21.2, U27.1 (LED+)
unnamed: R22.2, U26.1 (LED+)
unnamed: R23.2, U25.1 (LED+)
unnamed: R24.2, U24.1 (LED+)
unnamed: R25.2, U23.1 (LED+)
unnamed: R26.2, U22.1 (LED+)
unnamed: R27.2, U21.1 (LED+)
ROW1: U20.4 (SW+2), U20.6 (SW+1), X1.8 (F), X5.8 (F), X6.8 (F), X7.8 (F)
ROW2: U27.4 (SW+2), U27.6 (SW+1), X1.9 (F), X5.9 (F), X6.9 (F), X7.9 (F)
ROW3: U26.4 (SW+2), U26.6 (SW+1), X1.10 (F), X5.10 (F), X6.10 (F), X7.10 (F)
ROW4: U25.4 (SW+2), U25.6 (SW+1), X1.11 (F), X5.11 (F), X6.11 (F), X7.11 (F)
ROW5: U24.4 (SW+2), U24.6 (SW+1), X1.12 (F), X5.12 (F), X6.12 (F), X7.12 (F)
ROW6: U23.4 (SW+2), U23.6 (SW+1), X1.13 (F), X5.13 (F), X6.13 (F), X7.13 (F)
ROW7: U22.4 (SW+2), U22.6 (SW+1), X1.14 (F), X5.14 (F), X6.14 (F), X7.14 (F)
ROW8: U21.4 (SW+2), U21.6 (SW+1), X1.15 (F), X5.15 (F), X6.15 (F), X7.15 (F)

Notes on the sheet:
Pinout for FEMALE D-Sub connectors on PCB
Bank A
Bank B
Bank C

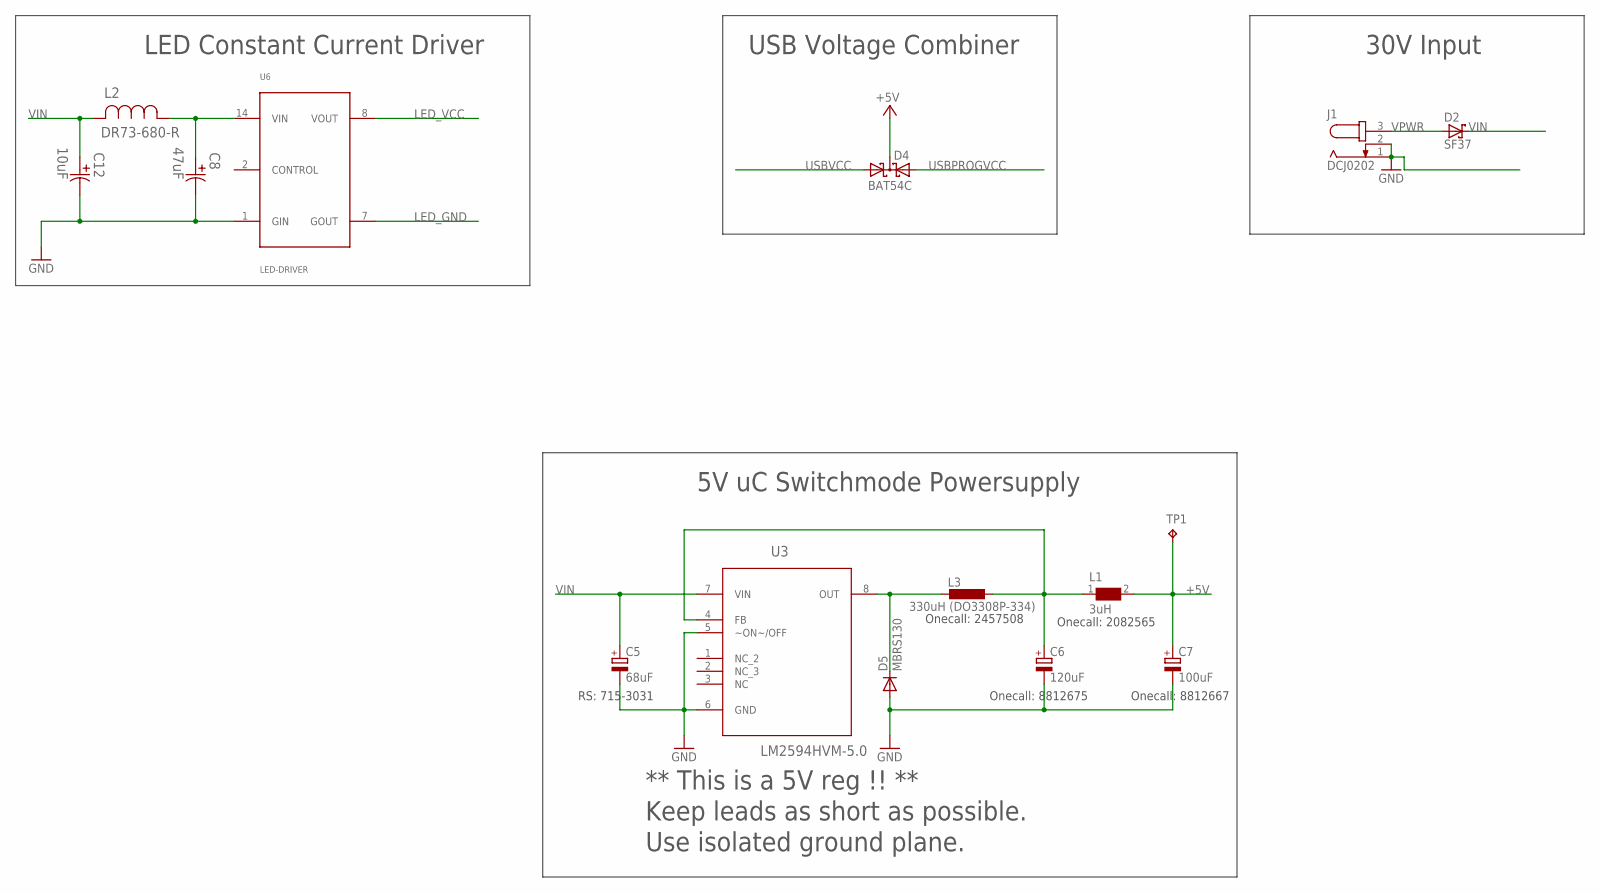
[picture p7: schematic rtiduino.sch, sheet 4, Power]

Parts:
C5: 68uF; E5-13
C6: 120uF; E5-13
C7: 100uF; E5-13
C8: 47uF; CAPAE830X1050N
C12: 10uF; CAPAE660X610N
D2: SF37; DO-201AD
D4: BAT54C; SOT23
D5: MBRS130; DO214AA
J1: DCJ0202; SPC4077
L1: 3uH; WE-TPC_5818/5828
L2: DR73-680-R; INDM7676X355N
L3: 330uH (DO3308P-334); DO3316P
TP1: TPB2,54; B2,54
U3: LM2594HVM-5.0; SOIC127P620X175-8N
U6: LED-DRIVER; LDU08

Connections:
+5V: C7.+, D4.3 (CC), L1.2, TP1.TP; also elsewhere on the board
GND: C5.-, C6.-, C7.-, C8.2, C12.2, D5.A, J1.1, J1.2, U3.5 (~ON~/OFF), U3.6 (GND), U6.1 (GIN); also elsewhere on the board
LED_GND: U6.7 (GOUT); also elsewhere on the board
LED_VCC: U6.8 (VOUT); also elsewhere on the board
unnamed: C6.+, L1.1, L3.2, U3.4 (FB)
unnamed: C8.1, L2.1, U6.14 (VIN)
unnamed: D5.C, L3.1, U3.8 (OUT)
USBPROGVCC: D4.2 (A2); also elsewhere on the board
USBVCC: D4.1 (A1); also elsewhere on the board
VIN: C5.+, C12.1, D2.1 (C), L2.2, U3.7 (VIN)
VPWR: D2.2 (A), J1.3

Notes on the sheet:
LED Constant Current Driver
USB Voltage Combiner
30V Input
** This is a 5V reg !! ** Keep leads as short as possible. Use isolated ground plane.
Onecall: 2457508
Onecall: 8812675
RS: 715-3031
Onecall: 8812667
Onecall: 2082565
5V uC Switchmode Powersupply

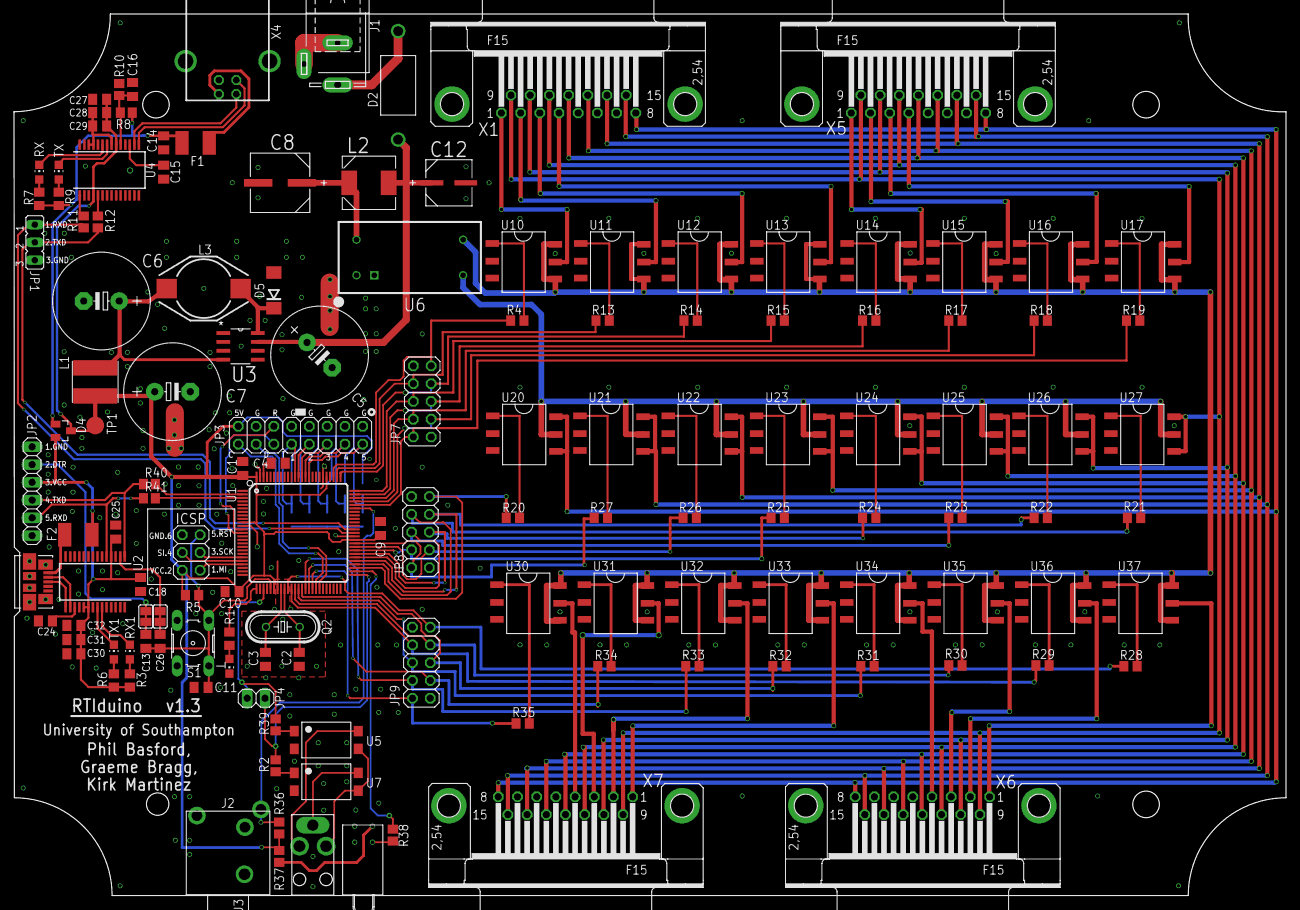
[picture p8: board rtiduino.brd from above]

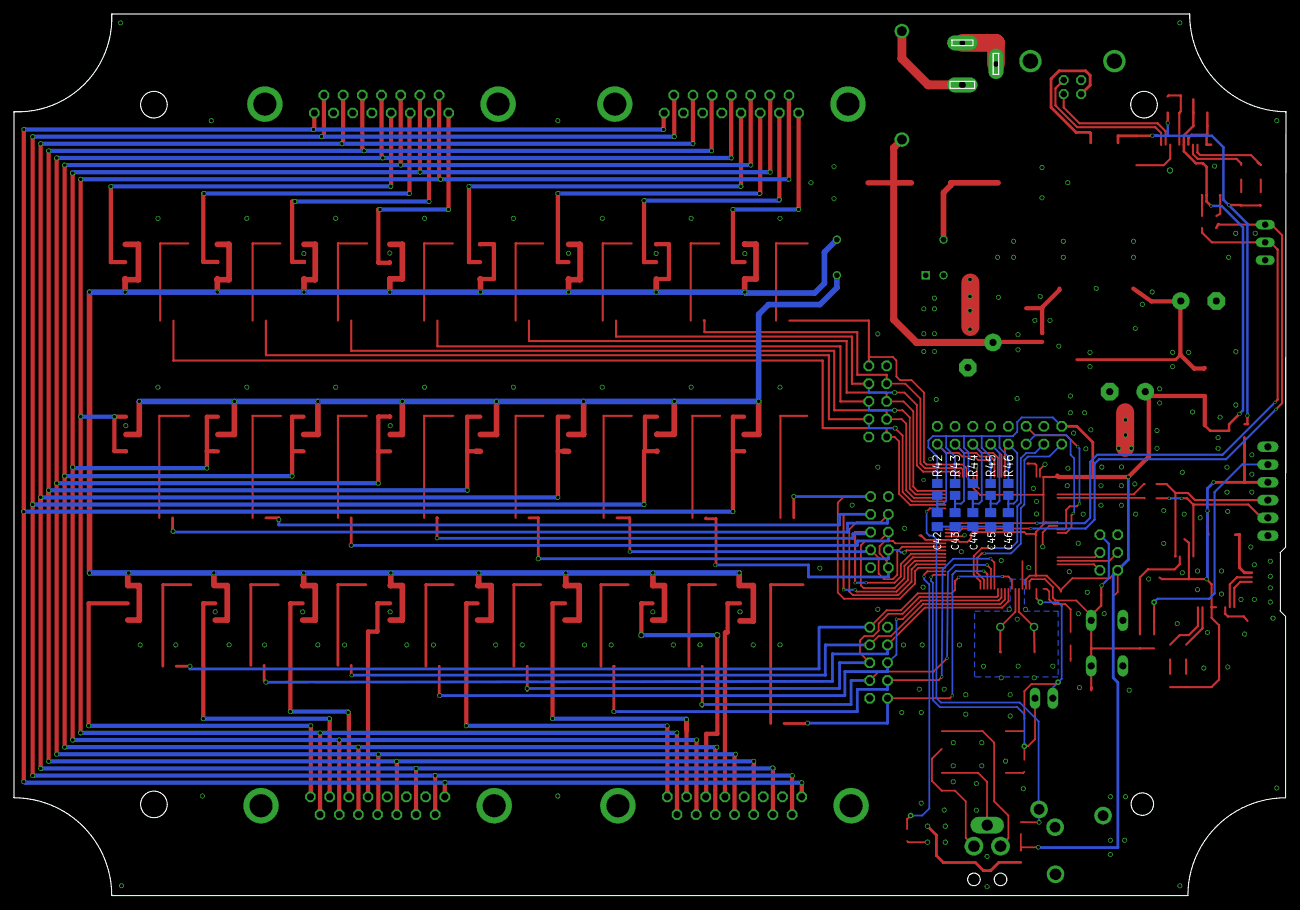
[picture p9: board rtiduino.brd from below]

Board: 2 copper layers, 181.8 x 126.0 mm, 144 parts (10 on the bottom side), 139 nets.
