rti-capture/rtiduino-pcb/(commit log)

2015-02-25 version 1.0
    [rtiduino.brd, rtiduino.sch]
2015-02-25 Latest version with * fixed PSU arrangement * more caps * connectors moved outwards
    [rtiduino.brd, rtiduino.sch]
2018-06-06 Update wih Superdome PCB
    [Cable-Colour-Code.csv, LED Output Codes.csv, LED Output Codes.xlsx, LED-Wiring.sch, rtiduino-1.2.xlsx, rtiduino-BOM.csv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]
2018-06-06 BoM in excel format
    [dome12ControllerBoM.xlsx]
2020-06-24 Fix footprints for 2.5mm jack and opto-isolator
2020-06-24 Tweak to camera shutter trigger (split focus and shutter), tweak to serial programming, misc fixes
    [rtiduino.brd, rtiduino.sch]
2020-07-31 Version 1.3 of RTIDuino and updated order sheet
    [rtiduino-1.3.xlsx, rtiduino.brd, rtiduino.sch]
2020-07-31 First version of the tester PCB - need to finalise values
    [tester.brd, tester.sch]
2020-08-04 Final tweaks before ordering
    [rtiduino-1.3.xlsx, tester-1.0.xlsx, tester.brd, tester.sch]
2020-08-04 Add production gerbers
